atuleu/woodpecker/mx_key_drawing/mx_front.dxf

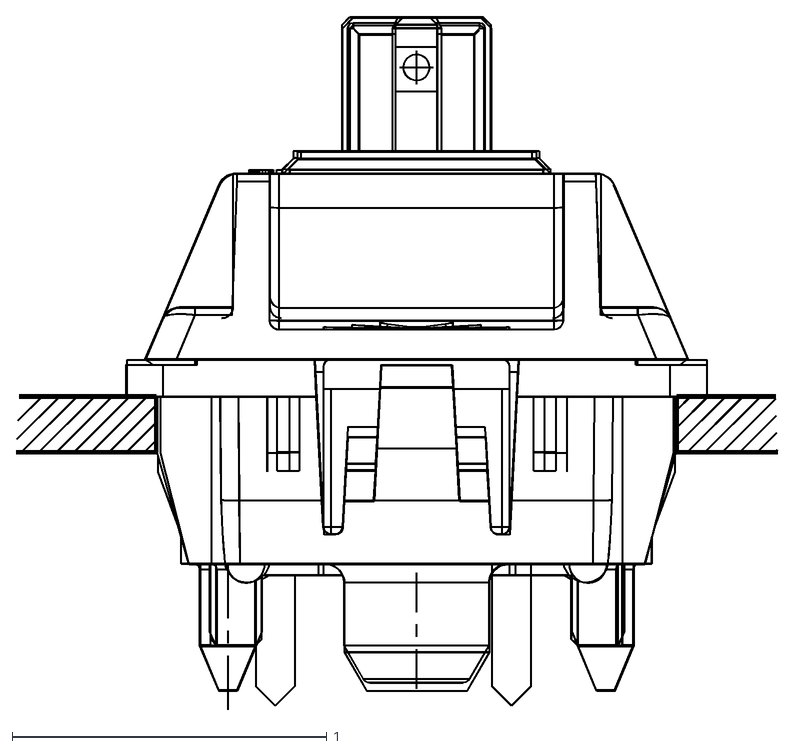
[picture p1: CAD file, 2022-06-14]
mx_key_drawing/mx_front.dxf
2.42 x 2.20
