atuleu/woodpecker/mx_key_drawing/mx_side.dxf

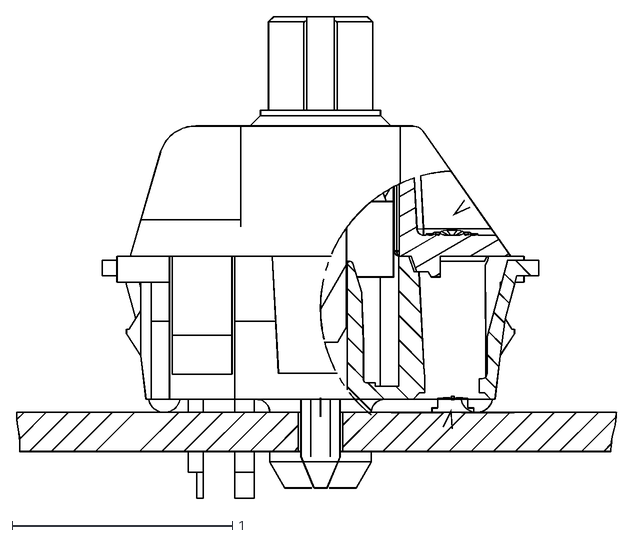
[picture p2: CAD file, 2022-06-14]
mx_key_drawing/mx_side.dxf
2.73 x 2.19
