atuleu/woodpecker/mx_key_drawing/mx_top.dxf

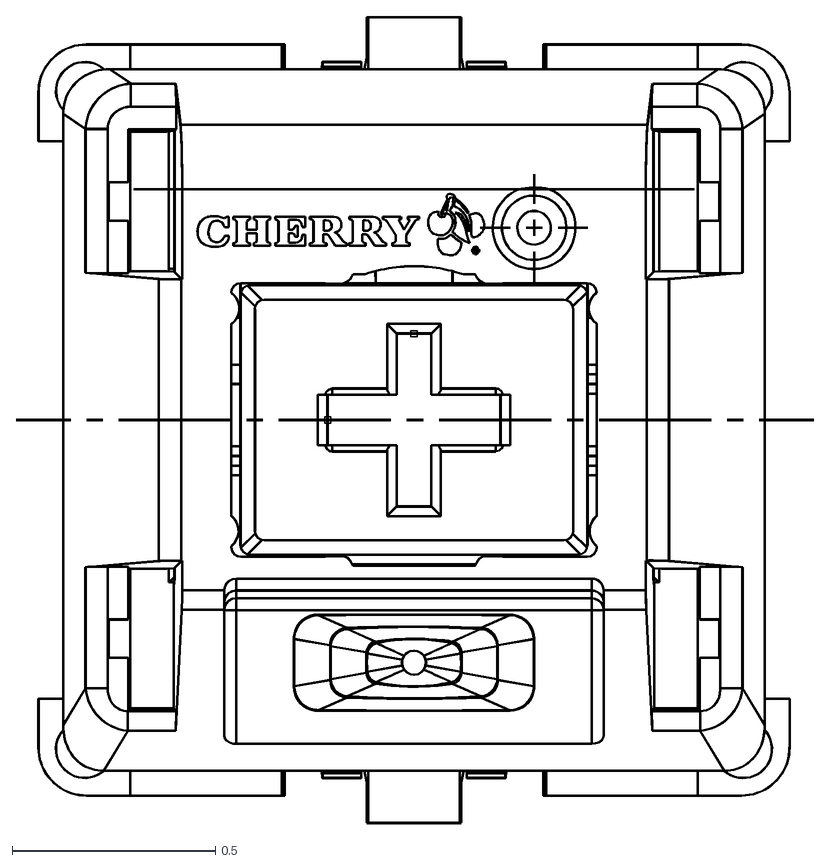
[picture p3: CAD file, 2022-06-14]
mx_key_drawing/mx_top.dxf
1.96 x 1.99
