atuleu/woodpecker/ecad/BottomSection/BottomSection.kicad_pcb

## KiCad design ecad/BottomSection/BottomSection.kicad_pcb (2021-03-28)

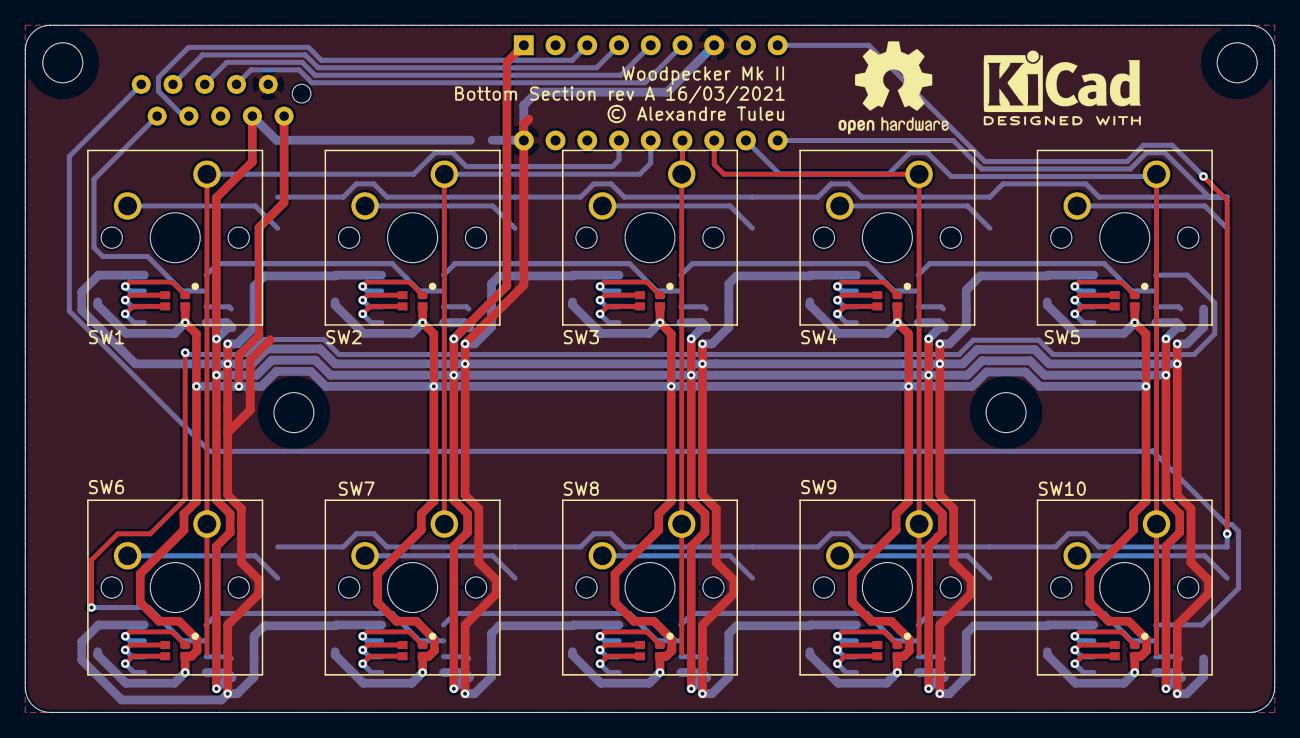
[picture p4: board BottomSection.kicad_pcb from above]

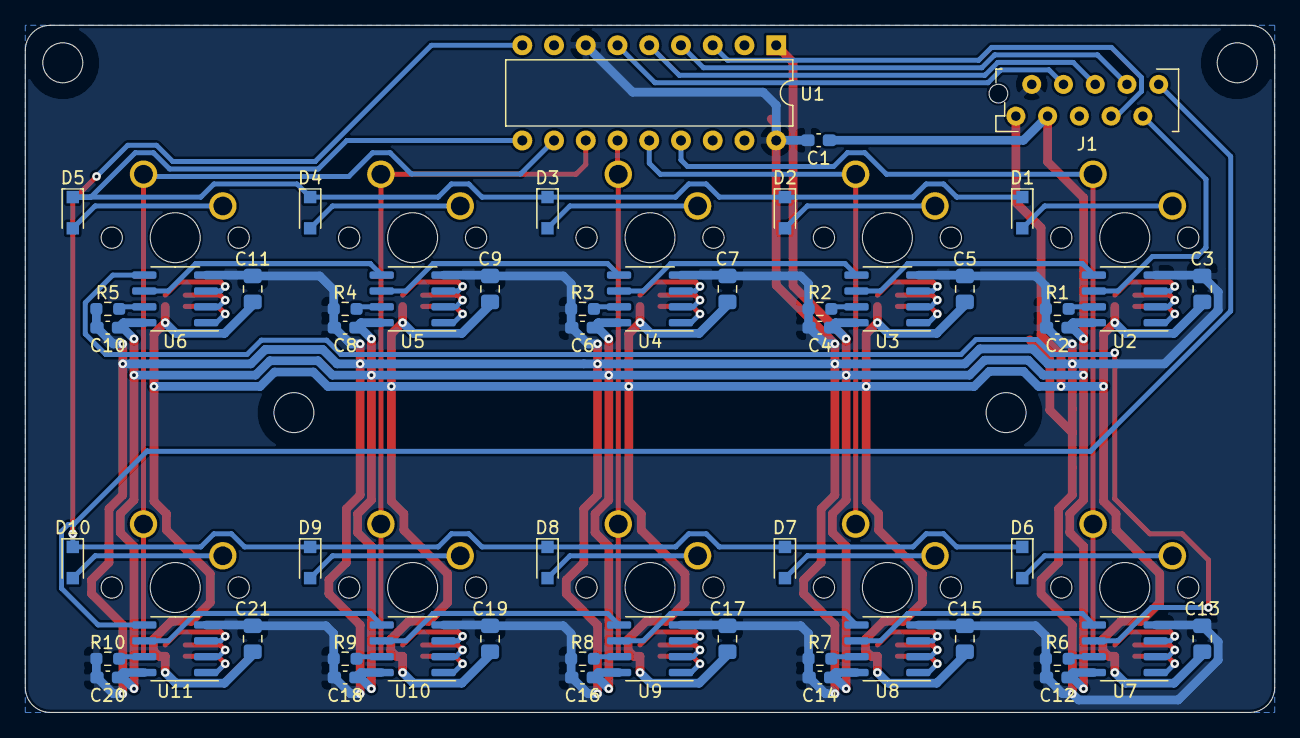
[picture p5: board BottomSection.kicad_pcb from below]

Board: 2 copper layers, 100.0 x 55.0 mm, 67 parts (53 on the bottom side), 75 nets.

Parts:
C1, C2, C4, C6, C8, C10, C12, C14, C16, C18, C20: 100nF; C_0603_1608Metric_Pad1.08x0.95mm_HandSolder
C3, C5, C7, C9, C11, C13, C15, C17, C19, C21: 2.2uF; C_0805_2012Metric_Pad1.18x1.45mm_HandSolder
D1, D2, D3, D4, D5, D6, D7, D8, D9, D10: 1N4148WS; D_SOD-323_HandSoldering
H1, H2, H3, H4: MountingHole; MountingHole_3.2mm_M3_DIN965
J1: Conn_02x05_Odd_Even; ConnectorMicromatch-10
R1, R2, R3, R4, R5, R6, R7, R8, R9, R10: 10.5K; R_0603_1608Metric_Pad0.98x0.95mm_HandSolder
SW1, SW2, SW3, SW4, SW5, SW6, SW7, SW8, SW9, SW10: Cherry_MX_LED; SW_Cherry_MX_1.00u_PCB_SMD_LED
U1: MCP23S09-xP; DIP-18_W7.62mm
U2, U3, U4, U5, U6, U7, U8, U9, U10, U11: TLC5973; SOIC-8_3.9x4.9mm_P1.27mm

Connections:
+3V3: C1.1, C2.1, C4.1, C6.1, C8.1, C10.1, C12.1, C14.1, C16.1, C18.1, C20.1, J1.3, U1.1, U2.8, U3.8, U4.8, U5.8, U6.8, U7.8, U8.8, U9.8, U10.8, U11.8
/C1: SW1.5, SW6.5, U1.15
/C2: SW2.5, SW7.5, U1.14
/C3: SW3.5, SW8.5, U1.13
/C4: SW4.5, SW9.5, U1.12
/C5: SW5.5, SW10.5, U1.11
/DI: J1.9, U2.6
/DO: J1.10, U11.5
/MISO: J1.4, U1.6
/MOSI: J1.6, U1.5
/MX_2/DI: U2.5, U3.6
/MX_3/DI: U3.5, U4.6
/MX_4/DI: U4.5, U5.6
/MX_5/DI: U5.5, U6.6
/MX_6/DI: U6.5, U7.6
/MX_7/DI: U7.5, U8.6
/MX_8/DI: U8.5, U9.6
/MX_9/DI: U9.5, U10.6
/MX_10/DI: U10.5, U11.6
/R1: D1.1, D2.1, D3.1, D4.1, D5.1, U1.10
/R2: D6.1, D7.1, D8.1, D9.1, D10.1, U1.9
/SCK: J1.8, U1.4
/~CS_ROW: J1.7, U1.3
GND: C1.2, C2.2, C3.2, C4.2, C5.2, C6.2, C7.2, C8.2, C9.2, C10.2, C11.2, C12.2, C13.2, C14.2, C15.2, C16.2, C17.2, C18.2, C19.2, C20.2, C21.2, J1.2, R1.2, R2.2, R3.2, R4.2, R5.2, R6.2, R7.2, R8.2, R9.2, R10.2, U1.7, U1.18, U2.4, U3.4, U4.4, U5.4, U6.4, U7.4, U8.4, U9.4, U10.4, U11.4
unnamed: D1.2, SW1.6
unnamed: D2.2, SW2.6
unnamed: D3.2, SW3.6
unnamed: D4.2, SW4.6
unnamed: D5.2, SW5.6
unnamed: D6.2, SW6.6
unnamed: D7.2, SW7.6
unnamed: D8.2, SW8.6
unnamed: D9.2, SW9.6
unnamed: D10.2, SW10.6
unnamed: R1.1, U2.7
unnamed: R2.1, U3.7
unnamed: R3.1, U4.7
unnamed: R4.1, U5.7
unnamed: R5.1, U6.7
unnamed: R6.1, U7.7
unnamed: R7.1, U8.7
unnamed: R8.1, U9.7
unnamed: R9.1, U10.7
unnamed: R10.1, U11.7
unnamed: SW1.1, U2.3
unnamed: SW1.2, U2.2
unnamed: SW1.4, U2.1
unnamed: SW2.1, U3.3
unnamed: SW2.2, U3.2
unnamed: SW2.4, U3.1
unnamed: SW3.1, U4.3
unnamed: SW3.2, U4.2
unnamed: SW3.4, U4.1
unnamed: SW4.1, U5.3
unnamed: SW4.2, U5.2
unnamed: SW4.4, U5.1
unnamed: SW5.1, U6.3
unnamed: SW5.2, U6.2
unnamed: SW5.4, U6.1
unnamed: SW6.1, U7.3
unnamed: SW6.2, U7.2
unnamed: SW6.4, U7.1
unnamed: SW7.1, U8.3
unnamed: SW7.2, U8.2
unnamed: SW7.4, U8.1
unnamed: SW8.1, U9.3
unnamed: SW8.2, U9.2
unnamed: SW8.4, U9.1
unnamed: SW9.1, U10.3
unnamed: SW9.2, U10.2
unnamed: SW9.4, U10.1
unnamed: SW10.1, U11.3
unnamed: SW10.2, U11.2
unnamed: SW10.4, U11.1
VLED: C3.1, C5.1, C7.1, C9.1, C11.1, C13.1, C15.1, C17.1, C19.1, C21.1, J1.1, SW1.3, SW2.3, SW3.3, SW4.3, SW5.3, SW6.3, SW7.3, SW8.3, SW9.3, SW10.3
