atuleu/woodpecker/ecad/TestBoard/TestBoard.kicad_pcb

## KiCad design ecad/TestBoard/TestBoard.kicad_pcb (2021-03-28)

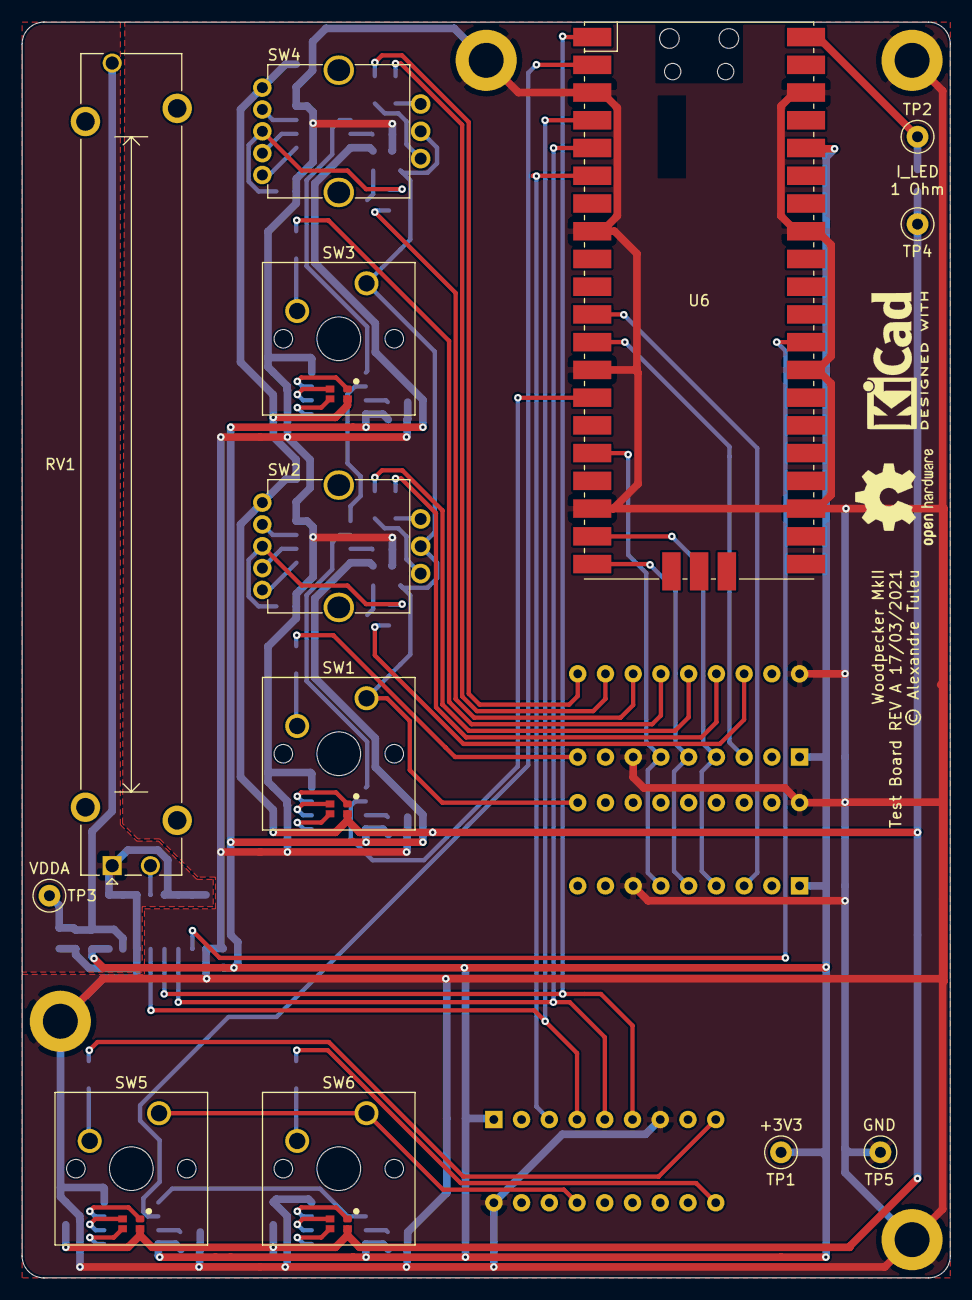
[picture p6: board TestBoard.kicad_pcb from above]

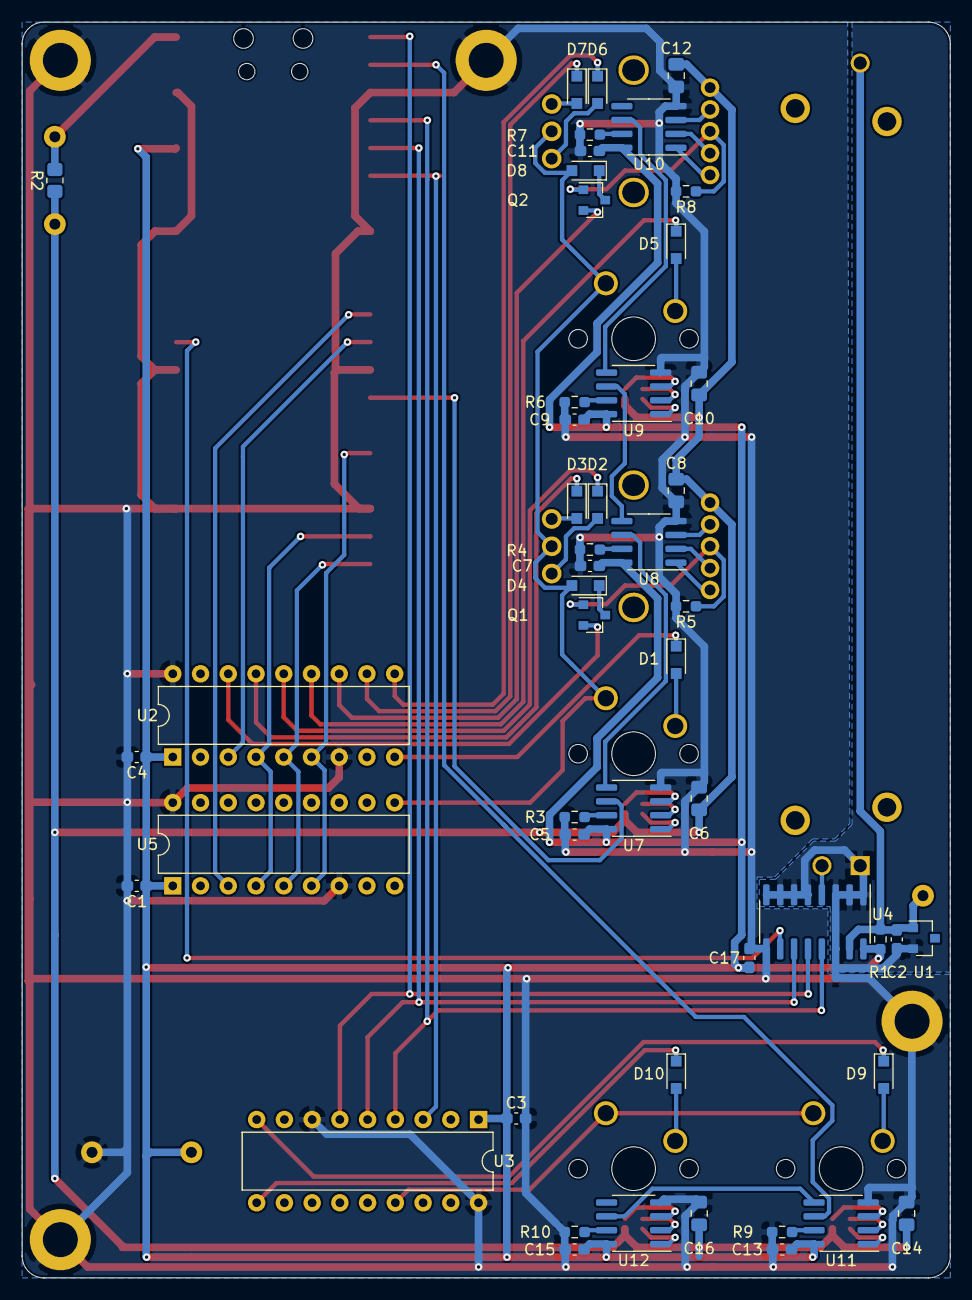
[picture p7: board TestBoard.kicad_pcb from below]

Board: 2 copper layers, 85.0 x 115.0 mm, 64 parts (51 on the bottom side), 71 nets.

Parts:
C1, C2, C3, C4, C5, C7, C9, C11, C13, C15, C17: 100nF; C_0603_1608Metric_Pad1.08x0.95mm_HandSolder
C6, C8, C10, C12, C14, C16: 2.2uF; C_0805_2012Metric_Pad1.18x1.45mm_HandSolder
D1, D2, D3, D4, D5, D6, D7, D8, D9, D10: 1N4148WS; D_SOD-323_HandSoldering
JP1: Jumper; jumper_0_4
Q1, Q2: BSS138; SOT-23
R1: 43R; R_0603_1608Metric_Pad0.98x0.95mm_HandSolder
R2: 1, 1/4W; R_0805_2012Metric_Pad1.20x1.40mm_HandSolder
R3, R4, R6, R7, R9, R10: 10.5K; R_0603_1608Metric_Pad0.98x0.95mm_HandSolder
R5, R8: 10K; R_0603_1608Metric_Pad0.98x0.95mm_HandSolder
RV1: R_POT; Potentiometer_Bourns_PTA6043_Single_Slide
SW1, SW3, SW5, SW6: Cherry_MX_LED; SW_Cherry_MX_1.00u_PCB_SMD_LED
SW2, SW4: PEL12T; PEL12T-4xxxS-S1024
TP1: 3V3; TestPoint_Loop_D2.50mm_Drill1.0mm_LowProfile
TP2: VBUS; TestPoint_Loop_D2.50mm_Drill1.0mm_LowProfile
TP3: VDDA; TestPoint_Loop_D2.50mm_Drill1.0mm_LowProfile
TP4: VLED; TestPoint_Loop_D2.50mm_Drill1.0mm_LowProfile
TP5: GND; TestPoint_Loop_D2.50mm_Drill1.0mm_LowProfile
U1: LM4040DBZ-3; SOT-23
U2, U3, U5: MCP23S09-xP; DIP-18_W7.62mm
U4: MCP3008; SOIC-16_3.9x9.9mm_P1.27mm
U6: RPI_Pico; RPi_Pico_SMD
U7, U8, U9, U10, U11, U12: TLC5973; SOIC-8_3.9x4.9mm_P1.27mm

Connections:
+3V3: C1.1, C3.1, C4.1, C5.1, C7.1, C9.1, C11.1, C13.1, C15.1, C17.1, R1.1, TP1.1, U2.1, U3.1, U4.16, U5.1, U6.36, U7.8, U8.8, U9.8, U10.8, U11.8, U12.8
/BOT_C_DI: U6.2, U11.6
/BOT_MISO: U3.6, U4.12, U6.1
/BOT_MOSI: U3.5, U4.11, U6.5
/BOT_SCK: U3.4, U4.13, U6.4
/CBOT: SW5.5, SW6.5, U3.15
/CTOP: D4.2, D8.2, SW1.5, SW2.C, SW3.5, SW4.C, U5.10
/PT1: RV1.2, U4.4
/QA1: D6.1, U2.10
/QA2: D2.1, U2.14
/QB1: D7.1, U2.11
/QB2: D3.1, U2.15
/R1: Q2.2, U2.12
/R2: D5.1, U2.13
/R3: Q1.2, U2.16
/R4: D1.1, U2.9
/R5: D9.1, U3.9
/R6: D10.1, U3.10
/Sheet60629BEB/DI: U9.5, U10.6
/Sheet60634508/DI: U8.5, U9.6
/TOP_C_DI: U6.14, U7.6
/TOP_MISO: U2.6, U5.6, U6.16
/TOP_MOSI: U2.5, U5.5, U6.20
/TOP_SCK: U2.4, U5.4, U6.19
/sheet607AC642/DI: U11.5, U12.6
/sheet60638B8E/DI: U7.5, U8.6
/~CS_ADC_C: U4.10, U6.29
/~CS_COL_C: U5.3, U6.11
/~CS_MX_C: U3.3, U6.6
/~CS_ROW_C: U2.3, U6.12
GND: C1.2, C3.2, C4.2, C5.2, C6.2, C7.2, C8.2, C9.2, C10.2, C11.2, C12.2, C13.2, C14.2, C15.2, C16.2, C17.2, JP1.2, R3.2, R4.2, R5.2, R6.2, R7.2, R8.2, R9.2, R10.2, TP5.1, U2.7, U2.18, U3.7, U3.18, U4.9, U5.7, U5.18, U6.3, U6.8, U6.13, U6.18, U6.23, U6.28, U6.33, U6.38, U7.4, U8.4, U9.4, U10.4, U11.4, U12.4
GND1: C2.2, JP1.1, RV1.1, U1.2, U4.1, U4.2, U4.3, U4.5, U4.6, U4.7, U4.8, U4.14
unnamed: D1.2, SW1.6
unnamed: D2.2, SW2.A
unnamed: D3.2, SW2.B
unnamed: D4.1, Q1.3
unnamed: D5.2, SW3.6
unnamed: D6.2, SW4.A
unnamed: D7.2, SW4.B
unnamed: D8.1, Q2.3
unnamed: D9.2, SW5.6
unnamed: D10.2, SW6.6
unnamed: Q1.1, R5.1, SW2.3
unnamed: Q2.1, R8.1, SW4.3
unnamed: R3.1, U7.7
unnamed: R4.1, U8.7
unnamed: R6.1, U9.7
unnamed: R7.1, U10.7
unnamed: R9.1, U11.7
unnamed: R10.1, U12.7
unnamed: SW1.1, U7.3
unnamed: SW1.2, U7.2
unnamed: SW1.4, U7.1
unnamed: SW2.1, U8.1
unnamed: SW2.2, U8.2
unnamed: SW2.4, U8.3
unnamed: SW3.1, U9.3
unnamed: SW3.2, U9.2
unnamed: SW3.4, U9.1
unnamed: SW4.1, U10.1
unnamed: SW4.2, U10.2
unnamed: SW4.4, U10.3
unnamed: SW5.1, U11.3
unnamed: SW5.2, U11.2
unnamed: SW5.4, U11.1
unnamed: SW6.1, U12.3
unnamed: SW6.2, U12.2
unnamed: SW6.4, U12.1
VBUS: R2.2, TP2.1, U6.40
VDDA: C2.1, R1.2, RV1.3, TP3.1, U1.1, U4.15
VLED: C6.1, C8.1, C10.1, C12.1, C14.1, C16.1, R2.1, SW1.3, SW2.5, SW3.3, SW4.5, SW5.3, SW6.3, TP4.1
