atuleu/woodpecker/ecad/MiddleSection/MiddleSection.kicad_pcb

## KiCad design ecad/MiddleSection/MiddleSection.kicad_pcb (2021-03-28)

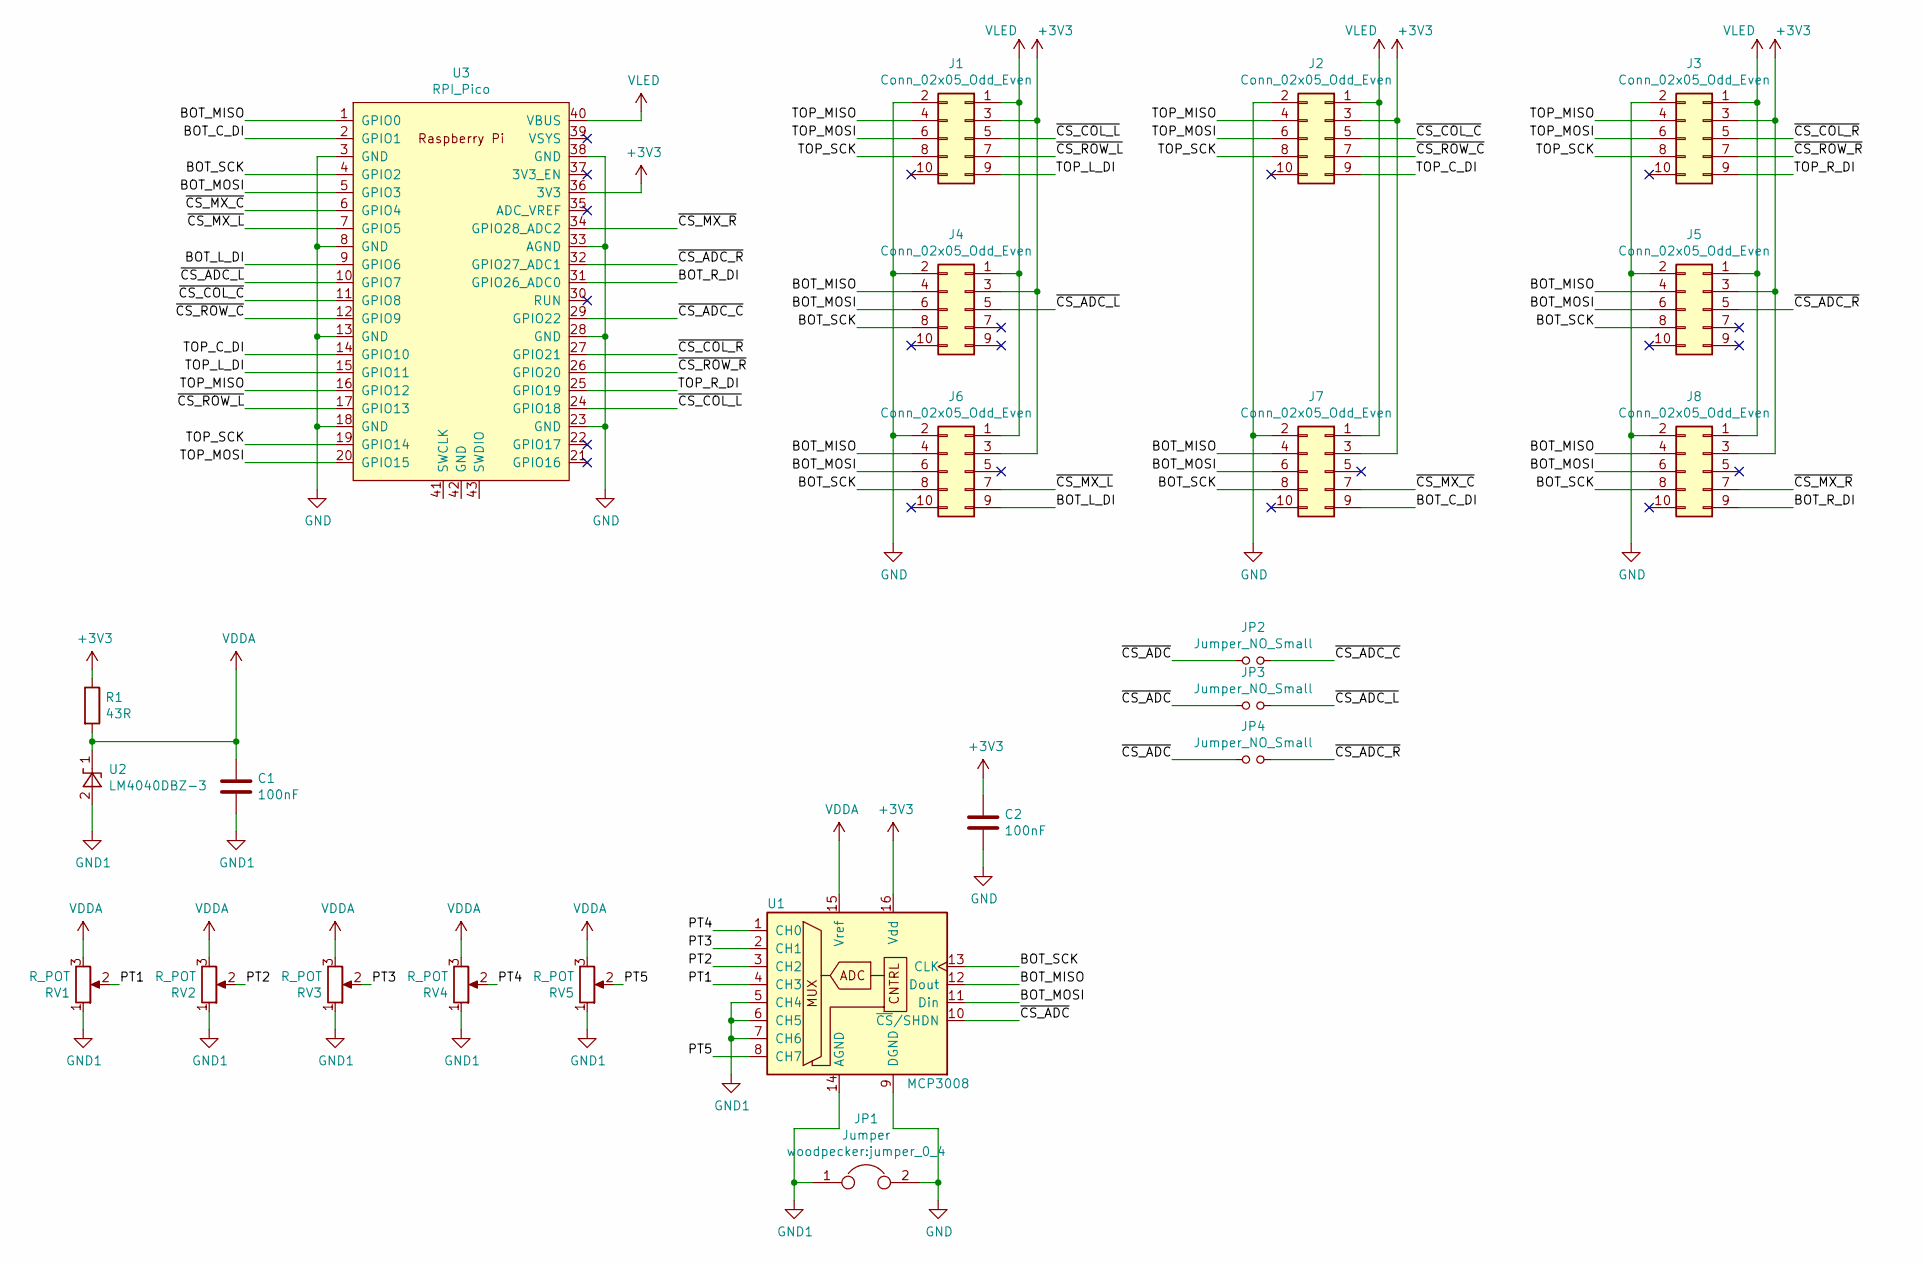
[picture p8: schematic MiddleSection.sch]

Parts:
C1, C2: 100nF; C_0603_1608Metric_Pad1.08x0.95mm_HandSolder
J1, J2, J3, J4, J5, J6, J7, J8: Conn_02x05_Odd_Even; ConnectorMicromatch-10
JP1: Jumper; jumper_0_4
JP2, JP3, JP4: Jumper_NO_Small; SolderJumper-2_P1.3mm_Open_RoundedPad1.0x1.5mm
R1: 43R; R_0603_1608Metric_Pad0.98x0.95mm_HandSolder
RV1, RV2, RV3, RV4, RV5: R_POT; Potentiometer_Bourns_PTA6043_Single_Slide
U1: MCP3008; SOIC-16_3.9x9.9mm_P1.27mm
U2: LM4040DBZ-3; SOT-23
U3: RPI_Pico; RPi_Pico_SMD_TH

Connections:
+3V3: C2.1, J1.3, J2.3, J3.3, J4.3, J5.3, J6.3, J7.3, J8.3, R1.1, U1.16 (Vdd), U3.36 (3V3)
/BOT_C_DI: J7.9, U3.2 (GPIO1)
/BOT_L_DI: J6.9, U3.9 (GPIO6)
/BOT_MISO: J4.4, J5.4, J6.4, J7.4, J8.4, U1.12 (Dout), U3.1 (GPIO0)
/BOT_MOSI: J4.6, J5.6, J6.6, J7.6, J8.6, U1.11 (Din), U3.5 (GPIO3)
/BOT_R_DI: J8.9, U3.31 (GPIO26_ADC0)
/BOT_SCK: J4.8, J5.8, J6.8, J7.8, J8.8, U1.13 (CLK), U3.4 (GPIO2)
/PT1: RV1.2, U1.4 (CH3)
/PT2: RV2.2, U1.3 (CH2)
/PT3: RV3.2, U1.2 (CH1)
/PT4: RV4.2, U1.1 (CH0)
/PT5: RV5.2, U1.8 (CH7)
/TOP_C_DI: J2.9, U3.14 (GPIO10)
/TOP_L_DI: J1.9, U3.15 (GPIO11)
/TOP_MISO: J1.4, J2.4, J3.4, U3.16 (GPIO12)
/TOP_MOSI: J1.6, J2.6, J3.6, U3.20 (GPIO15)
/TOP_R_DI: J3.9, U3.25 (GPIO19)
/TOP_SCK: J1.8, J2.8, J3.8, U3.19 (GPIO14)
/~CS_ADC: JP2.1, JP3.1, JP4.1, U1.10 (~CS~/SHDN)
/~CS_ADC_C: JP2.2, U3.29 (GPIO22)
/~CS_ADC_L: J4.5, JP3.2, U3.10 (GPIO7)
/~CS_ADC_R: J5.5, JP4.2, U3.32 (GPIO27_ADC1)
/~CS_COL_C: J2.5, U3.11 (GPIO8)
/~CS_COL_L: J1.5, U3.24 (GPIO18)
/~CS_COL_R: J3.5, U3.27 (GPIO21)
/~CS_MX_C: J7.7, U3.6 (GPIO4)
/~CS_MX_L: J6.7, U3.7 (GPIO5)
/~CS_MX_R: J8.7, U3.34 (GPIO28_ADC2)
/~CS_ROW_C: J2.7, U3.12 (GPIO9)
/~CS_ROW_L: J1.7, U3.17 (GPIO13)
/~CS_ROW_R: J3.7, U3.26 (GPIO20)
GND: C2.2, J1.2, J2.2, J3.2, J4.2, J5.2, J6.2, J7.2, J8.2, JP1.2, U1.9 (DGND), U3.3 (GND), U3.8 (GND), U3.13 (GND), U3.18 (GND), U3.23 (GND), U3.28 (GND), U3.33 (AGND), U3.38 (GND)
GND1: C1.2, JP1.1, RV1.1, RV2.1, RV3.1, RV4.1, RV5.1, U1.5 (CH4), U1.6 (CH5), U1.7 (CH6), U1.14 (AGND), U2.2 (A)
VDDA: C1.1, R1.2, RV1.3, RV2.3, RV3.3, RV4.3, RV5.3, U1.15 (Vref), U2.1 (K)
VLED: J1.1, J2.1, J3.1, J4.1, J5.1, J6.1, J7.1, J8.1, U3.40 (VBUS)

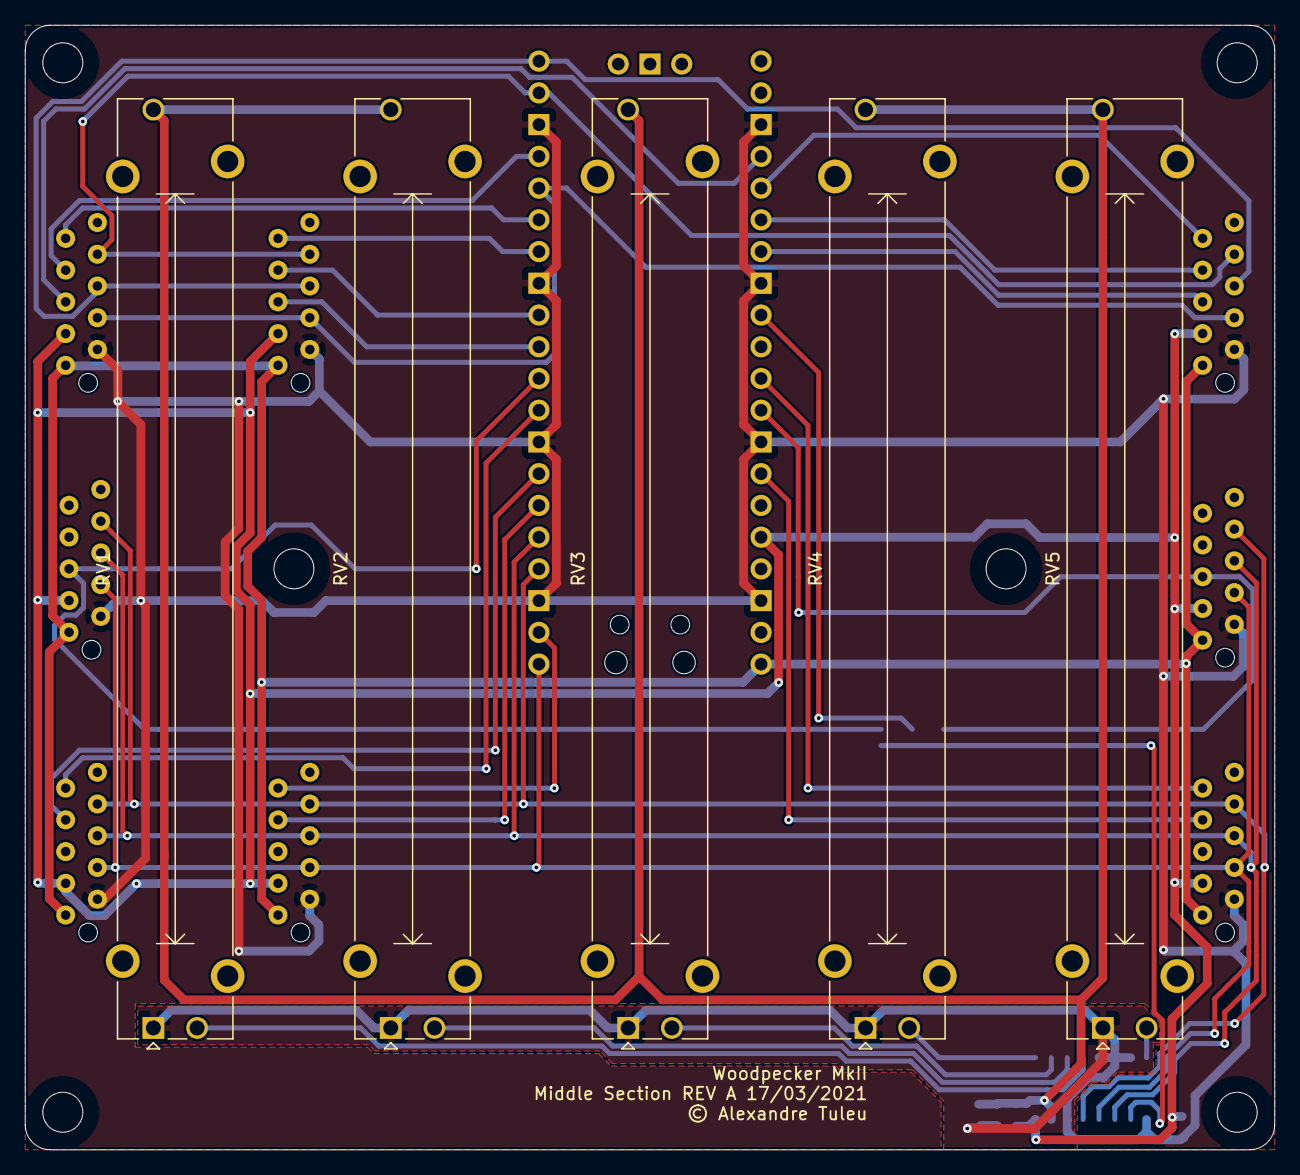
[picture p9: board MiddleSection.kicad_pcb from above]

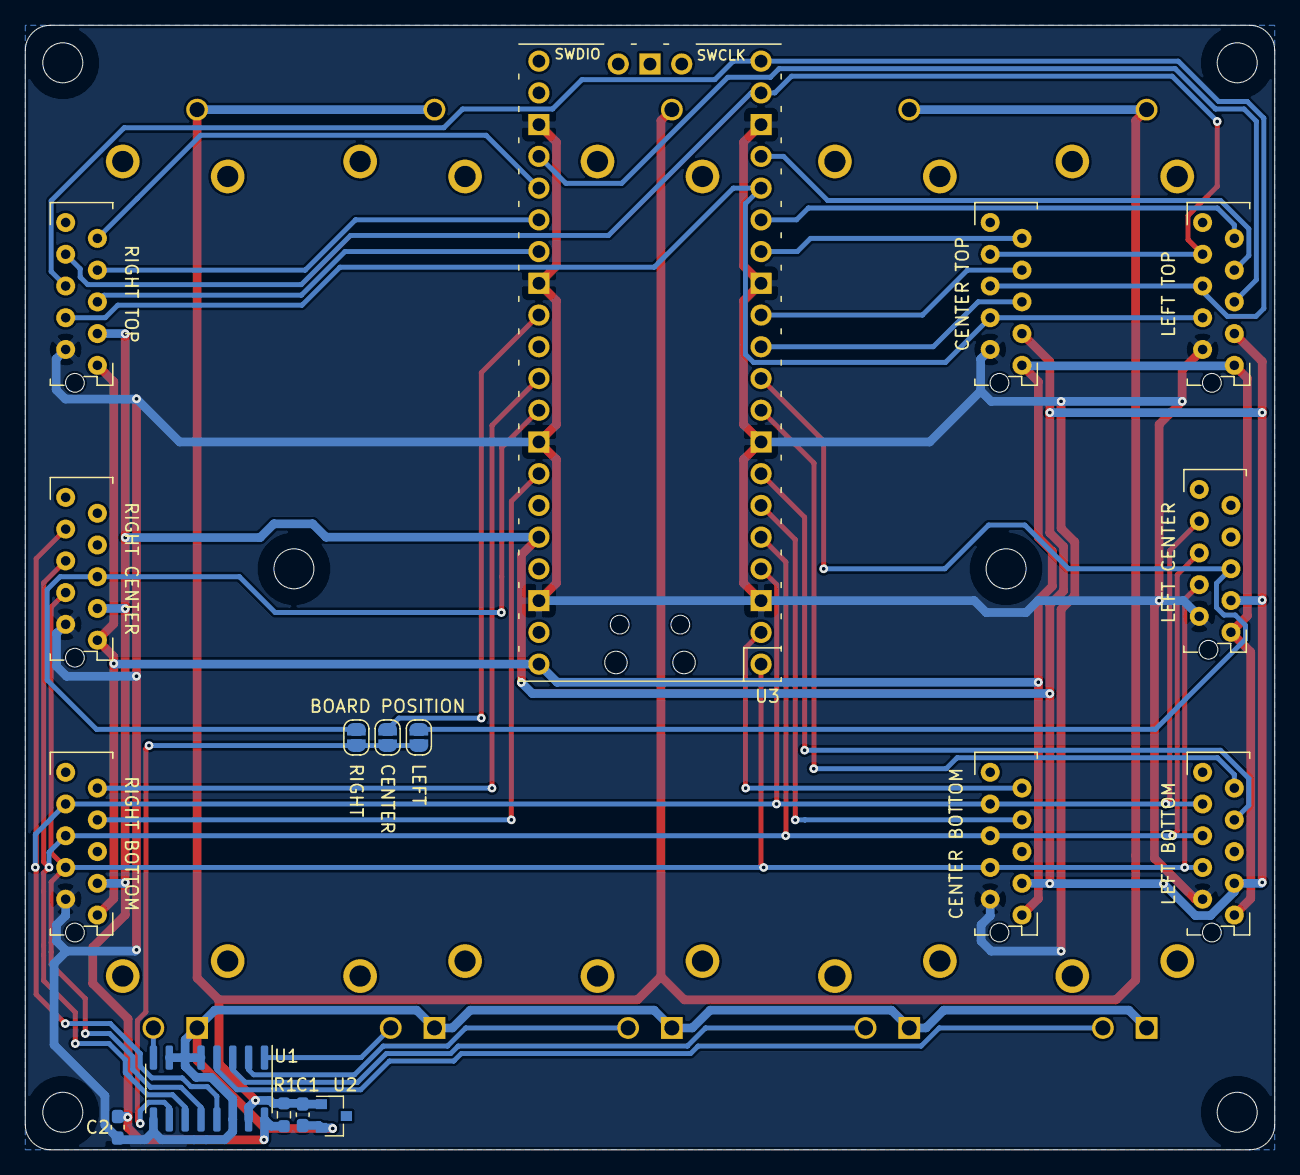
[picture p10: board MiddleSection.kicad_pcb from below]

Board: 2 copper layers, 100.0 x 90.0 mm, 23 parts (18 on the bottom side), 35 nets.
