atuleu/woodpecker/ecad/TopSection/TopSection.kicad_pcb

## KiCad design ecad/TopSection/TopSection.kicad_pcb (2021-03-28)

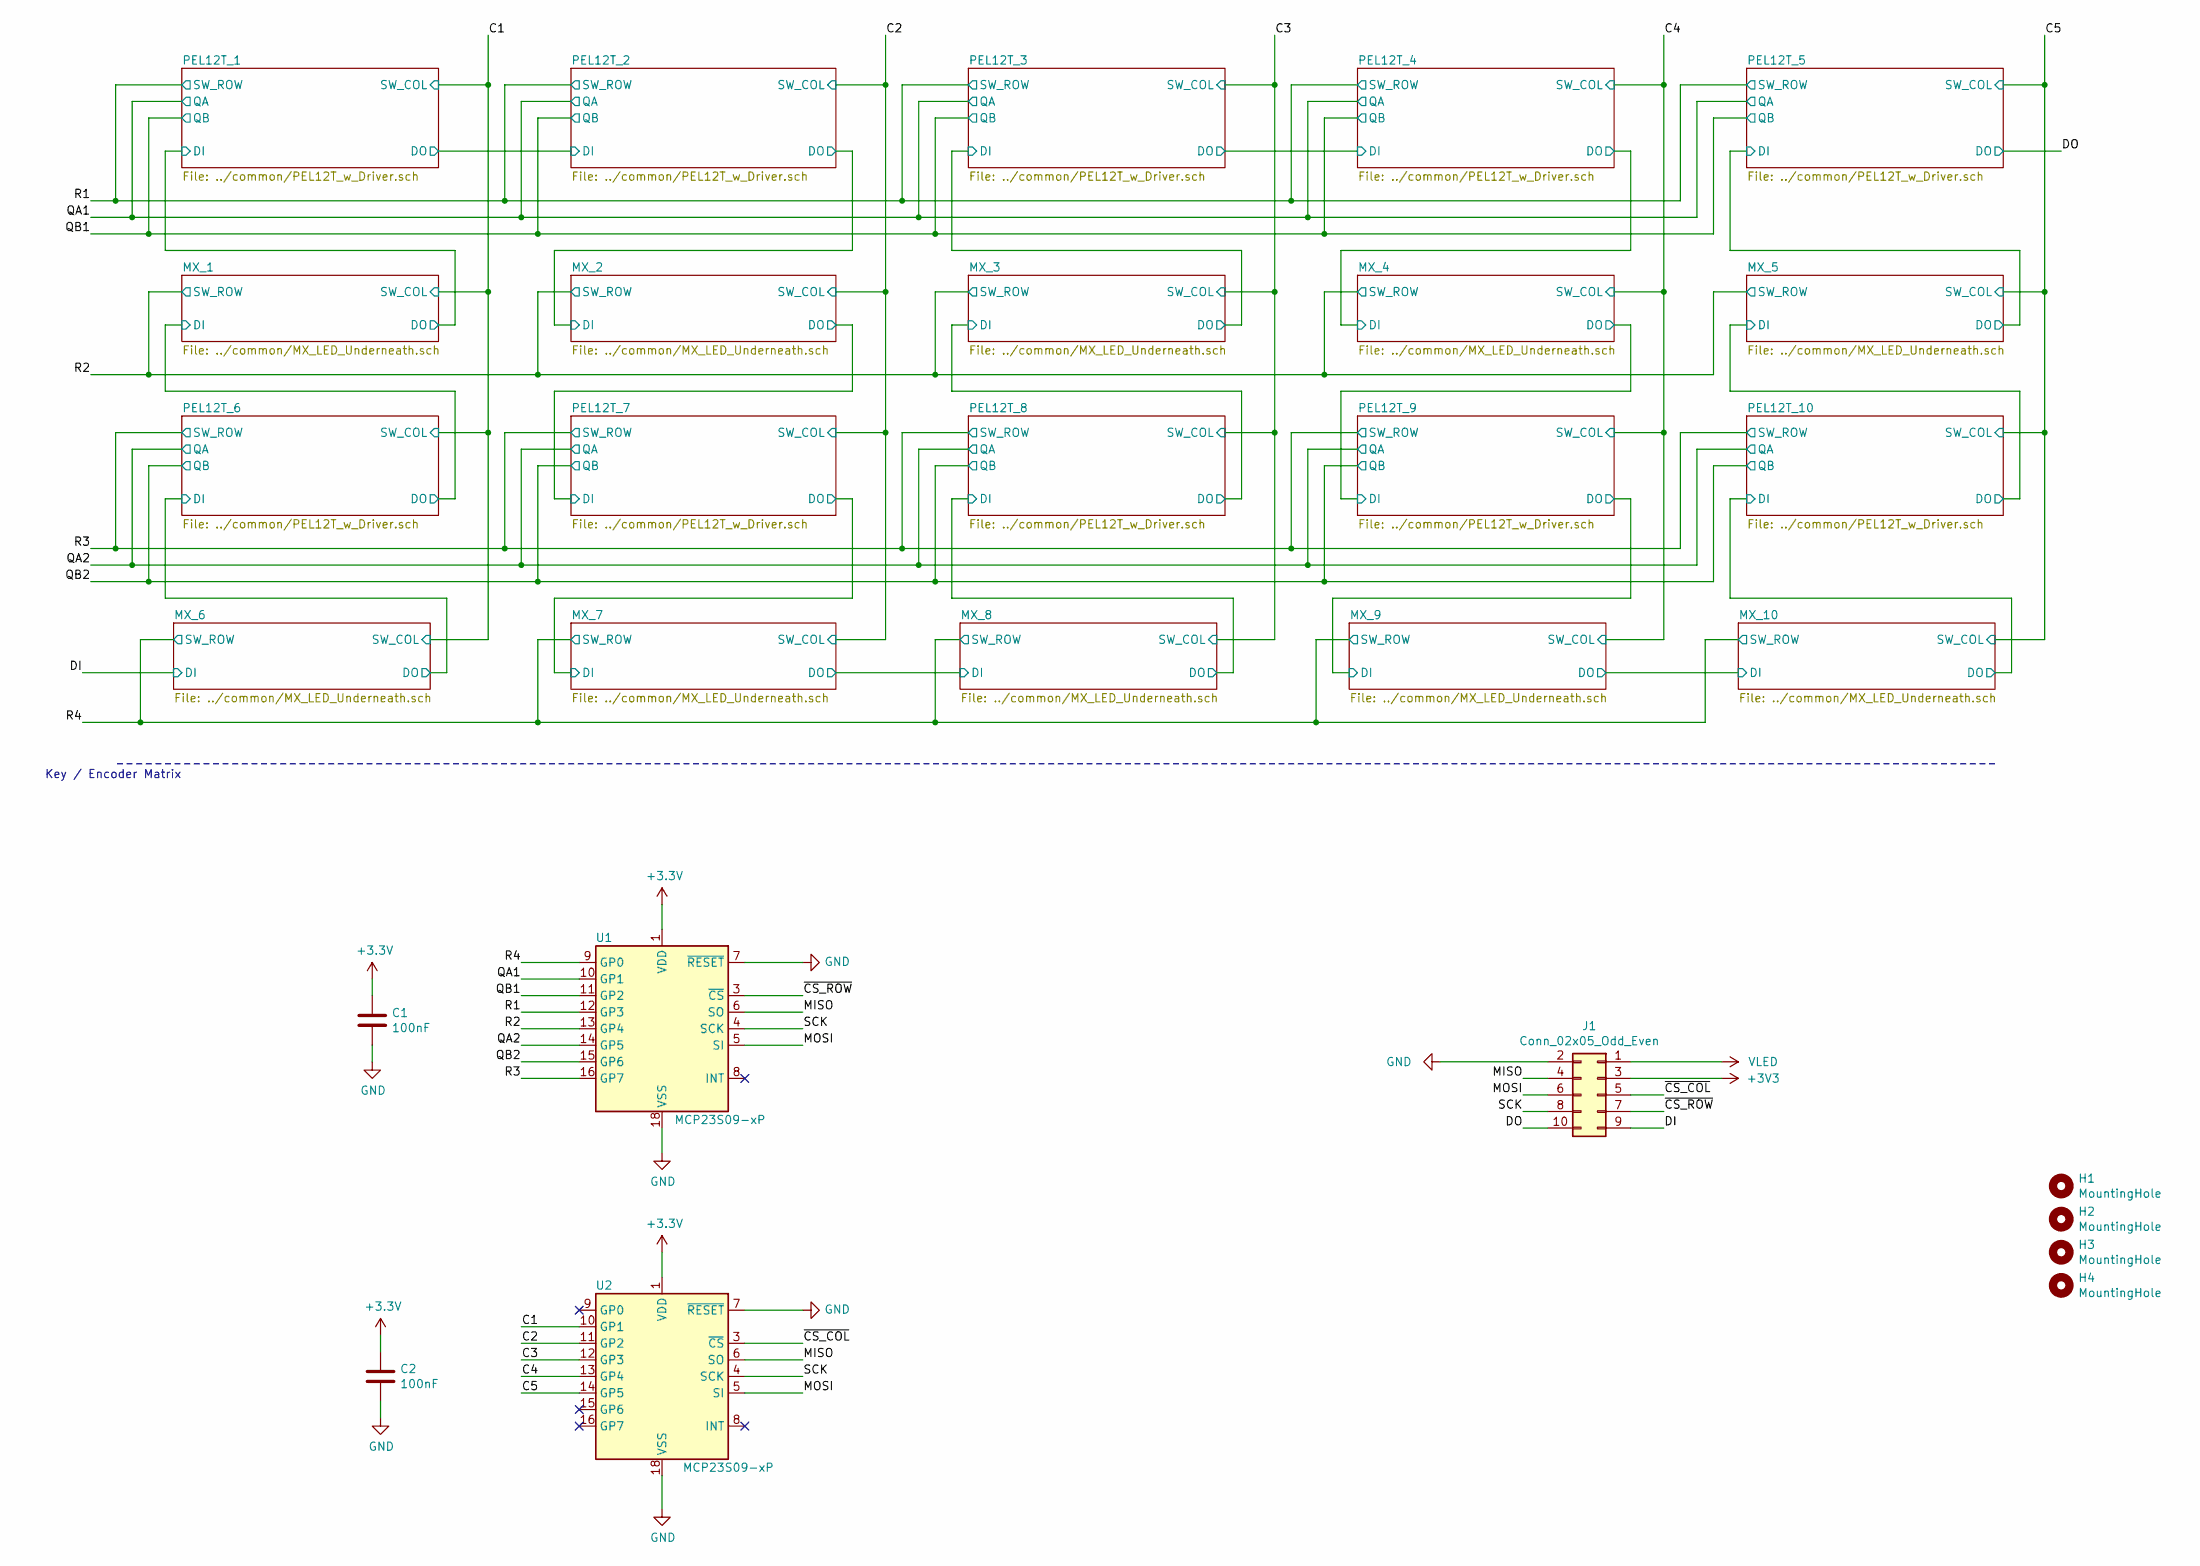
[picture p11: schematic TopSection.sch]

Parts:
C1, C2: 100nF; C_0603_1608Metric_Pad1.08x0.95mm_HandSolder
H1, H2, H3, H4: MountingHole; MountingHole_3.2mm_M3_DIN965
J1: Conn_02x05_Odd_Even; ConnectorMicromatch-10
U1, U2: MCP23S09-xP; DIP-18_W7.62mm

Connections:
/C1: U2.10 (GP1); also elsewhere on the board
/C2: U2.11 (GP2); also elsewhere on the board
/C3: U2.12 (GP3); also elsewhere on the board
/C4: U2.13 (GP4); also elsewhere on the board
/C5: U2.14 (GP5); also elsewhere on the board
/DI: J1.9; also elsewhere on the board
/DO: J1.10; also elsewhere on the board
/MISO: J1.4, U1.6 (SO), U2.6 (SO)
/MOSI: J1.6, U1.5 (SI), U2.5 (SI)
/QA1: U1.10 (GP1); also elsewhere on the board
/QA2: U1.14 (GP5); also elsewhere on the board
/QB1: U1.11 (GP2); also elsewhere on the board
/QB2: U1.15 (GP6); also elsewhere on the board
/R1: U1.12 (GP3); also elsewhere on the board
/R2: U1.13 (GP4); also elsewhere on the board
/R3: U1.16 (GP7); also elsewhere on the board
/R4: U1.9 (GP0); also elsewhere on the board
/SCK: J1.8, U1.4 (SCK), U2.4 (SCK)
/~CS_COL: J1.5, U2.3 (~CS)
/~CS_ROW: J1.7, U1.3 (~CS)
GND: C1.2, C2.2, J1.2, U1.7 (~RESET), U1.18 (VSS), U2.7 (~RESET), U2.18 (VSS); also elsewhere on the board
VLED: J1.1; also elsewhere on the board

Notes on the sheet:
Key / Encoder Matrix
