atuleu/woodpecker/ecad/TopSection/TopSection.kicad_pcb

## KiCad design ecad/TopSection/TopSection.kicad_pcb (continued)

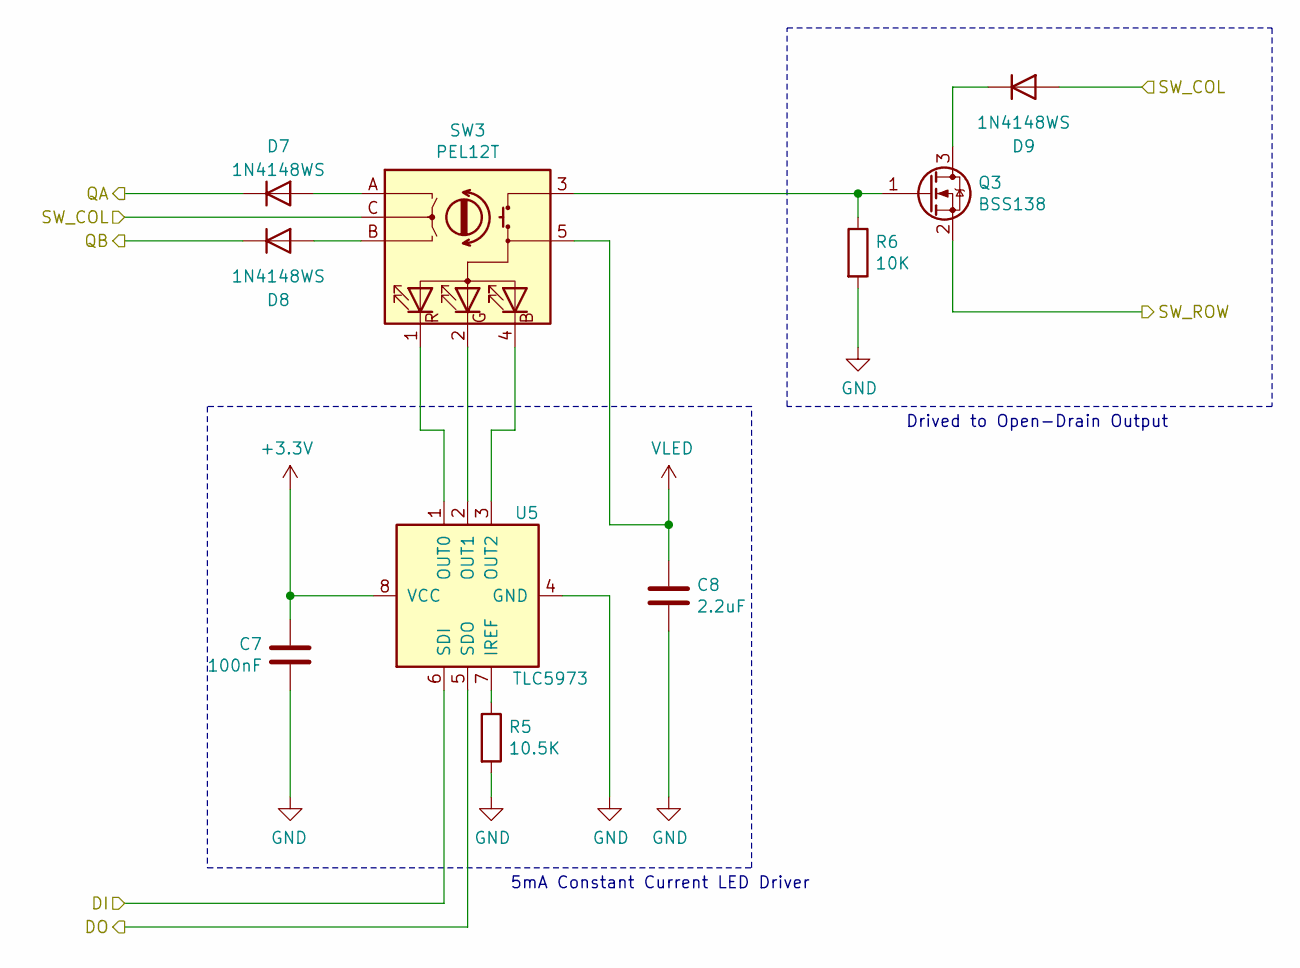
[picture p12: schematic PEL12T_w_Driver.sch]

Parts:
C3: 100nF; C_0603_1608Metric_Pad1.08x0.95mm_HandSolder
C4: 2.2uF; C_0805_2012Metric_Pad1.18x1.45mm_HandSolder
D1, D2, D3: 1N4148WS; D_SOD-323_HandSoldering
Q1: BSS138; SOT-23
R1: 10.5K; R_0603_1608Metric_Pad0.98x0.95mm_HandSolder
R2: 10K; R_0603_1608Metric_Pad0.98x0.95mm_HandSolder
SW1: PEL12T; PEL12T-4xxxS-S1024
U3: TLC5973; SOIC-8_3.9x4.9mm_P1.27mm

Connections:
/C1: D3.2 (A), SW1.C; also elsewhere on the board
/PEL12T_1/DI: U3.6 (SDI); also elsewhere on the board
/PEL12T_2/DI: U3.5 (SDO); also elsewhere on the board
/QA1: D1.1 (K); also elsewhere on the board
/QB1: D2.1 (K); also elsewhere on the board
/R1: Q1.2 (S); also elsewhere on the board
GND: C3.2, C4.2, R1.2, R2.2, U3.4 (GND); also elsewhere on the board
unnamed: D1.2 (A), SW1.A
unnamed: D2.2 (A), SW1.B
unnamed: D3.1 (K), Q1.3 (D)
unnamed: Q1.1 (G), R2.1, SW1.3
unnamed: R1.1, U3.7 (IREF)
unnamed: SW1.1 (RK), U3.1 (OUT0)
unnamed: SW1.2 (GK), U3.2 (OUT1)
unnamed: SW1.4 (BK), U3.3 (OUT2)
VLED: C4.1, SW1.5 (A); also elsewhere on the board

Parts of its further copies:
C5, C7, C9, C11, C23, C25, C27, C29, C31: 100nF; C_0603_1608Metric_Pad1.08x0.95mm_HandSolder
C6, C8, C10, C12, C24, C26, C28, C30, C32: 2.2uF; C_0805_2012Metric_Pad1.18x1.45mm_HandSolder
D4, D5, D6, D7, D8, D9, D10, D11, D12, D13, D14, D15, D21, D22, D23, D24, D25, D26, D27, D28, D29, D30, D31, D32, D33, D34, D35: 1N4148WS; D_SOD-323_HandSoldering
Q2, Q3, Q4, Q5, Q6, Q7, Q8, Q9, Q10: BSS138; SOT-23
R3, R7, R9, R16, R18, R20, R22, R24: 10.5K; R_0603_1608Metric_Pad0.98x0.95mm_HandSolder
R4, R6, R8, R10, R17, R19, R21, R23, R25: 10K; R_0603_1608Metric_Pad0.98x0.95mm_HandSolder
SW2, SW3, SW4, SW5, SW11, SW12, SW13, SW14, SW15: PEL12T; PEL12T-4xxxS-S1024
U4, U5, U6, U7, U10, U13, U14, U15, U16, U17: TLC5973; SOIC-8_3.9x4.9mm_P1.27mm

Connections of its further copies:
/C1: D23.2 (A), SW11.C; also elsewhere on the board
/C2: D6.2 (A), D26.2 (A), SW2.C, SW12.C; also elsewhere on the board
/C3: D9.2 (A), D29.2 (A), SW3.C, SW13.C; also elsewhere on the board
/C4: D12.2 (A), D32.2 (A), SW4.C, SW14.C; also elsewhere on the board
/C5: D15.2 (A), D35.2 (A), SW5.C, SW15.C; also elsewhere on the board
/DO: U7.5 (SDO); also elsewhere on the board
/MX_1/DI: U13.5 (SDO); also elsewhere on the board
/MX_2/DI: U4.5 (SDO); also elsewhere on the board
/MX_3/DI: U10.6 (SDI), U15.5 (SDO)
/MX_4/DI: U6.5 (SDO); also elsewhere on the board
/MX_5/DI: U17.5 (SDO); also elsewhere on the board
/MX_7/DI: U14.5 (SDO); also elsewhere on the board
/MX_9/DI: U16.5 (SDO); also elsewhere on the board
/PEL12T_2/DI: U4.6 (SDI); also elsewhere on the board
/PEL12T_3/DI: U5.6 (SDI), U10.5 (SDO)
/PEL12T_4/DI: U5.5 (SDO), U6.6 (SDI)
/PEL12T_5/DI: U7.6 (SDI); also elsewhere on the board
/PEL12T_6/DI: U13.6 (SDI); also elsewhere on the board
/PEL12T_7/DI: U14.6 (SDI); also elsewhere on the board
/PEL12T_8/DI: U15.6 (SDI); also elsewhere on the board
/PEL12T_9/DI: U16.6 (SDI); also elsewhere on the board
/PEL12T_10/DI: U17.6 (SDI); also elsewhere on the board
/QA1: D4.1 (K), D7.1 (K), D10.1 (K), D13.1 (K); also elsewhere on the board
/QA2: D21.1 (K), D24.1 (K), D27.1 (K), D30.1 (K), D33.1 (K); also elsewhere on the board
/QB1: D5.1 (K), D8.1 (K), D11.1 (K), D14.1 (K); also elsewhere on the board
/QB2: D22.1 (K), D25.1 (K), D28.1 (K), D31.1 (K), D34.1 (K); also elsewhere on the board
/R1: Q2.2 (S), Q3.2 (S), Q4.2 (S), Q5.2 (S); also elsewhere on the board
/R3: Q6.2 (S), Q7.2 (S), Q8.2 (S), Q9.2 (S), Q10.2 (S); also elsewhere on the board
GND: C5.2, C6.2, C7.2, C8.2, C9.2, C10.2, C11.2, C12.2, C23.2, C24.2, C25.2, C26.2, C27.2, C28.2, C29.2, C30.2, C31.2, C32.2, R3.2, R4.2, R6.2, R7.2, R8.2, R9.2, R10.2, R16.2, R17.2, R18.2, R19.2, R20.2, R21.2, R22.2, R23.2, R24.2, R25.2, U4.4 (GND), U5.4 (GND), U6.4 (GND), U7.4 (GND), U10.4 (GND), U13.4 (GND), U14.4 (GND), U15.4 (GND), U16.4 (GND), U17.4 (GND); also elsewhere on the board
unnamed: D4.2 (A), SW2.A
unnamed: D5.2 (A), SW2.B
unnamed: D6.1 (K), Q2.3 (D)
unnamed: D7.2 (A), SW3.A
unnamed: D8.2 (A), SW3.B
unnamed: D9.1 (K), Q3.3 (D)
unnamed: D10.2 (A), SW4.A
unnamed: D11.2 (A), SW4.B
unnamed: D12.1 (K), Q4.3 (D)
unnamed: D13.2 (A), SW5.A
unnamed: D14.2 (A), SW5.B
unnamed: D15.1 (K), Q5.3 (D)
unnamed: D21.2 (A), SW11.A
unnamed: D22.2 (A), SW11.B
unnamed: D23.1 (K), Q6.3 (D)
unnamed: D24.2 (A), SW12.A
unnamed: D25.2 (A), SW12.B
unnamed: D26.1 (K), Q7.3 (D)
unnamed: D27.2 (A), SW13.A
unnamed: D28.2 (A), SW13.B
unnamed: D29.1 (K), Q8.3 (D)
unnamed: D30.2 (A), SW14.A
unnamed: D31.2 (A), SW14.B
unnamed: D32.1 (K), Q9.3 (D)
unnamed: D33.2 (A), SW15.A
unnamed: D34.2 (A), SW15.B
unnamed: D35.1 (K), Q10.3 (D)
unnamed: Q2.1 (G), R4.1, SW2.3
unnamed: Q3.1 (G), R6.1, SW3.3
unnamed: Q4.1 (G), R8.1, SW4.3
unnamed: Q5.1 (G), R10.1, SW5.3
unnamed: Q6.1 (G), R17.1, SW11.3
unnamed: Q7.1 (G), R19.1, SW12.3
unnamed: Q8.1 (G), R21.1, SW13.3
unnamed: Q9.1 (G), R23.1, SW14.3
unnamed: Q10.1 (G), R25.1, SW15.3
unnamed: R3.1, U4.7 (IREF)
unnamed 92: U5.7 (IREF); also elsewhere on the board
unnamed: R7.1, U6.7 (IREF)
unnamed: R9.1, U7.7 (IREF)
unnamed 97: U10.7 (IREF); also elsewhere on the board
unnamed: R16.1, U13.7 (IREF)
unnamed: R18.1, U14.7 (IREF)
unnamed: R20.1, U15.7 (IREF)
unnamed: R22.1, U16.7 (IREF)
unnamed: R24.1, U17.7 (IREF)
unnamed: SW2.1 (RK), U4.1 (OUT0)
unnamed: SW2.2 (GK), U4.2 (OUT1)
unnamed: SW2.4 (BK), U4.3 (OUT2)
unnamed: SW3.1 (RK), U5.1 (OUT0)
unnamed: SW3.2 (GK), U5.2 (OUT1)
unnamed: SW3.4 (BK), U5.3 (OUT2)
unnamed: SW4.1 (RK), U6.1 (OUT0)
unnamed: SW4.2 (GK), U6.2 (OUT1)
unnamed: SW4.4 (BK), U6.3 (OUT2)
unnamed: SW5.1 (RK), U7.1 (OUT0)
unnamed: SW5.2 (GK), U7.2 (OUT1)
unnamed: SW5.4 (BK), U7.3 (OUT2)
unnamed 131: U10.3 (OUT2); also elsewhere on the board
unnamed 132: U10.2 (OUT1); also elsewhere on the board
unnamed 133: U10.1 (OUT0); also elsewhere on the board
unnamed: SW11.1 (RK), U13.1 (OUT0)
unnamed: SW11.2 (GK), U13.2 (OUT1)
unnamed: SW11.4 (BK), U13.3 (OUT2)
unnamed: SW12.1 (RK), U14.1 (OUT0)
unnamed: SW12.2 (GK), U14.2 (OUT1)
unnamed: SW12.4 (BK), U14.3 (OUT2)
unnamed: SW13.1 (RK), U15.1 (OUT0)
unnamed: SW13.2 (GK), U15.2 (OUT1)
unnamed: SW13.4 (BK), U15.3 (OUT2)
unnamed: SW14.1 (RK), U16.1 (OUT0)
unnamed: SW14.2 (GK), U16.2 (OUT1)
unnamed: SW14.4 (BK), U16.3 (OUT2)
unnamed: SW15.1 (RK), U17.1 (OUT0)
unnamed: SW15.2 (GK), U17.2 (OUT1)
unnamed: SW15.4 (BK), U17.3 (OUT2)
VLED: C6.1, C8.1, C10.1, C12.1, C24.1, C26.1, C28.1, C30.1, C32.1, SW2.5 (A), SW3.5 (A), SW4.5 (A), SW5.5 (A), SW11.5 (A), SW12.5 (A), SW13.5 (A), SW14.5 (A), SW15.5 (A); also elsewhere on the board

Notes on the sheet:
5mA Constant Current LED Driver
Drived to Open-Drain Output

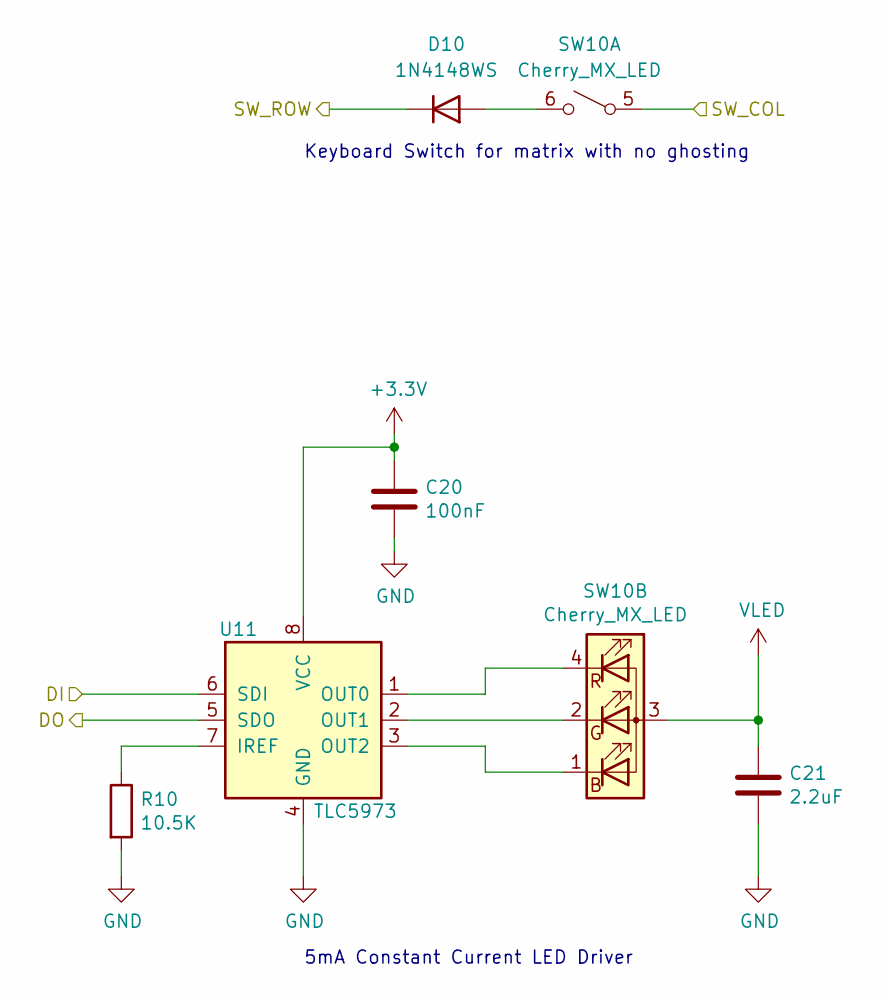
[picture p13: schematic MX_LED_Underneath.sch]

Parts:
C13: 100nF; C_0603_1608Metric_Pad1.08x0.95mm_HandSolder
C14: 2.2uF; C_0805_2012Metric_Pad1.18x1.45mm_HandSolder
D16: 1N4148WS; D_SOD-323_HandSoldering
R11: 10.5K; R_0603_1608Metric_Pad0.98x0.95mm_HandSolder
SW6: Cherry_MX_LED; SW_Cherry_MX_1.00u_PCB_SMD_LED
U8: TLC5973; SOIC-8_3.9x4.9mm_P1.27mm

Connections:
/C1: SW6.5 (SW_A); also elsewhere on the board
/MX_1/DI: U8.6 (SDI); also elsewhere on the board
/PEL12T_1/DI: U8.5 (SDO); also elsewhere on the board
/R2: D16.1 (K); also elsewhere on the board
GND: C13.2, C14.2, R11.2, U8.4 (GND); also elsewhere on the board
unnamed: D16.2 (A), SW6.6 (SW_B)
unnamed: R11.1, U8.7 (IREF)
unnamed: SW6.1 (BK), U8.3 (OUT2)
unnamed: SW6.2 (GK), U8.2 (OUT1)
unnamed: SW6.4 (RK), U8.1 (OUT0)
VLED: C14.1, SW6.3 (A); also elsewhere on the board

Parts of its further copies:
C5, C9, C15, C17, C19, C21, C33, C35, C37, C39, C41: 100nF; C_0603_1608Metric_Pad1.08x0.95mm_HandSolder
C22, C34, C36, C38, C40, C42: 2.2uF; C_0805_2012Metric_Pad1.18x1.45mm_HandSolder
D4, D5, D6, D7, D8, D9, D10, D17, D18, D19, D20, D36, D37, D38, D39, D40: 1N4148WS; D_SOD-323_HandSoldering
R3, R5, R7, R9, R12, R13, R14, R15, R26, R27, R28, R29, R30: 10.5K; R_0603_1608Metric_Pad0.98x0.95mm_HandSolder
SW7, SW8, SW9, SW10, SW16, SW17, SW18, SW19, SW20: Cherry_MX_LED; SW_Cherry_MX_1.00u_PCB_SMD_LED
U4, U5, U6, U7, U9, U10, U11, U12, U18, U19, U20, U21, U22: TLC5973; SOIC-8_3.9x4.9mm_P1.27mm

Connections of its further copies:
/C1: SW16.5 (SW_A); also elsewhere on the board
/C2: D6.2 (A), SW7.5 (SW_A), SW17.5 (SW_A); also elsewhere on the board
/C3: D9.2 (A), SW8.5 (SW_A), SW18.5 (SW_A); also elsewhere on the board
/C4: SW9.5 (SW_A), SW19.5 (SW_A); also elsewhere on the board
/C5: SW10.5 (SW_A), SW20.5 (SW_A); also elsewhere on the board
/DI: U18.6 (SDI); also elsewhere on the board
/DO: U7.5 (SDO); also elsewhere on the board
/MX_2/DI: U4.5 (SDO), U9.6 (SDI)
/MX_3/DI: U10.6 (SDI); also elsewhere on the board
/MX_4/DI: U6.5 (SDO), U11.6 (SDI)
/MX_5/DI: U12.6 (SDI); also elsewhere on the board
/MX_7/DI: U19.6 (SDI); also elsewhere on the board
/MX_8/DI: U19.5 (SDO), U20.6 (SDI)
/MX_9/DI: U21.6 (SDI); also elsewhere on the board
/MX_10/DI: U21.5 (SDO), U22.6 (SDI)
/PEL12T_2/DI: U4.6 (SDI); also elsewhere on the board
/PEL12T_3/DI: U5.6 (SDI), U10.5 (SDO)
/PEL12T_4/DI: U5.5 (SDO), U6.6 (SDI)
/PEL12T_5/DI: U7.6 (SDI), U12.5 (SDO)
/PEL12T_6/DI: U18.5 (SDO); also elsewhere on the board
/PEL12T_7/DI: U9.5 (SDO); also elsewhere on the board
/PEL12T_8/DI: U20.5 (SDO); also elsewhere on the board
/PEL12T_9/DI: U11.5 (SDO); also elsewhere on the board
/PEL12T_10/DI: U22.5 (SDO); also elsewhere on the board
/QA1: D4.1 (K), D7.1 (K), D10.1 (K); also elsewhere on the board
/QB1: D5.1 (K), D8.1 (K); also elsewhere on the board
/R2: D17.1 (K), D18.1 (K), D19.1 (K), D20.1 (K); also elsewhere on the board
/R4: D36.1 (K), D37.1 (K), D38.1 (K), D39.1 (K), D40.1 (K); also elsewhere on the board
GND: C5.2, C9.2, C15.2, C17.2, C19.2, C21.2, C22.2, C33.2, C34.2, C35.2, C36.2, C37.2, C38.2, C39.2, C40.2, C41.2, C42.2, R3.2, R5.2, R7.2, R9.2, R12.2, R13.2, R14.2, R15.2, R26.2, R27.2, R28.2, R29.2, R30.2, U4.4 (GND), U5.4 (GND), U6.4 (GND), U7.4 (GND), U9.4 (GND), U10.4 (GND), U11.4 (GND), U12.4 (GND), U18.4 (GND), U19.4 (GND), U20.4 (GND), U21.4 (GND), U22.4 (GND); also elsewhere on the board
unnamed 43: D4.2 (A); also elsewhere on the board
unnamed 44: D5.2 (A); also elsewhere on the board
unnamed 45: D6.1 (K); also elsewhere on the board
unnamed 46: D7.2 (A); also elsewhere on the board
unnamed 47: D8.2 (A); also elsewhere on the board
unnamed 48: D9.1 (K); also elsewhere on the board
unnamed 49: D10.2 (A); also elsewhere on the board
unnamed: D17.2 (A), SW7.6 (SW_B)
unnamed: D18.2 (A), SW8.6 (SW_B)
unnamed: D19.2 (A), SW9.6 (SW_B)
unnamed: D20.2 (A), SW10.6 (SW_B)
unnamed: D36.2 (A), SW16.6 (SW_B)
unnamed: D37.2 (A), SW17.6 (SW_B)
unnamed: D38.2 (A), SW18.6 (SW_B)
unnamed: D39.2 (A), SW19.6 (SW_B)
unnamed: D40.2 (A), SW20.6 (SW_B)
unnamed: R3.1, U4.7 (IREF)
unnamed: R5.1, U5.7 (IREF)
unnamed: R7.1, U6.7 (IREF)
unnamed: R9.1, U7.7 (IREF)
unnamed: R12.1, U9.7 (IREF)
unnamed: R13.1, U10.7 (IREF)
unnamed: R14.1, U11.7 (IREF)
unnamed: R15.1, U12.7 (IREF)
unnamed: R26.1, U18.7 (IREF)
unnamed: R27.1, U19.7 (IREF)
unnamed: R28.1, U20.7 (IREF)
unnamed: R29.1, U21.7 (IREF)
unnamed: R30.1, U22.7 (IREF)
unnamed 113: U4.1 (OUT0); also elsewhere on the board
unnamed 114: U4.2 (OUT1); also elsewhere on the board
unnamed 115: U4.3 (OUT2); also elsewhere on the board
unnamed 116: U5.1 (OUT0); also elsewhere on the board
unnamed 117: U5.2 (OUT1); also elsewhere on the board
unnamed 118: U5.3 (OUT2); also elsewhere on the board
unnamed 119: U6.1 (OUT0); also elsewhere on the board
unnamed 120: U6.2 (OUT1); also elsewhere on the board
unnamed 121: U6.3 (OUT2); also elsewhere on the board
unnamed 122: U7.1 (OUT0); also elsewhere on the board
unnamed 123: U7.2 (OUT1); also elsewhere on the board
unnamed 124: U7.3 (OUT2); also elsewhere on the board
unnamed: SW7.1 (BK), U9.3 (OUT2)
unnamed: SW7.2 (GK), U9.2 (OUT1)
unnamed: SW7.4 (RK), U9.1 (OUT0)
unnamed: SW8.1 (BK), U10.3 (OUT2)
unnamed: SW8.2 (GK), U10.2 (OUT1)
unnamed: SW8.4 (RK), U10.1 (OUT0)
unnamed: SW9.1 (BK), U11.3 (OUT2)
unnamed: SW9.2 (GK), U11.2 (OUT1)
unnamed: SW9.4 (RK), U11.1 (OUT0)
unnamed: SW10.1 (BK), U12.3 (OUT2)
unnamed: SW10.2 (GK), U12.2 (OUT1)
unnamed: SW10.4 (RK), U12.1 (OUT0)
unnamed: SW16.1 (BK), U18.3 (OUT2)
unnamed: SW16.2 (GK), U18.2 (OUT1)
unnamed: SW16.4 (RK), U18.1 (OUT0)
unnamed: SW17.1 (BK), U19.3 (OUT2)
unnamed: SW17.2 (GK), U19.2 (OUT1)
unnamed: SW17.4 (RK), U19.1 (OUT0)
unnamed: SW18.1 (BK), U20.3 (OUT2)
unnamed: SW18.2 (GK), U20.2 (OUT1)
unnamed: SW18.4 (RK), U20.1 (OUT0)
unnamed: SW19.1 (BK), U21.3 (OUT2)
unnamed: SW19.2 (GK), U21.2 (OUT1)
unnamed: SW19.4 (RK), U21.1 (OUT0)
unnamed: SW20.1 (BK), U22.3 (OUT2)
unnamed: SW20.2 (GK), U22.2 (OUT1)
unnamed: SW20.4 (RK), U22.1 (OUT0)
VLED: C22.1, C34.1, C36.1, C38.1, C40.1, C42.1, SW7.3 (A), SW8.3 (A), SW9.3 (A), SW10.3 (A), SW16.3 (A), SW17.3 (A), SW18.3 (A), SW19.3 (A), SW20.3 (A); also elsewhere on the board

Notes on the sheet:
5mA Constant Current LED Driver
Keyboard Switch for matrix with no ghosting

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
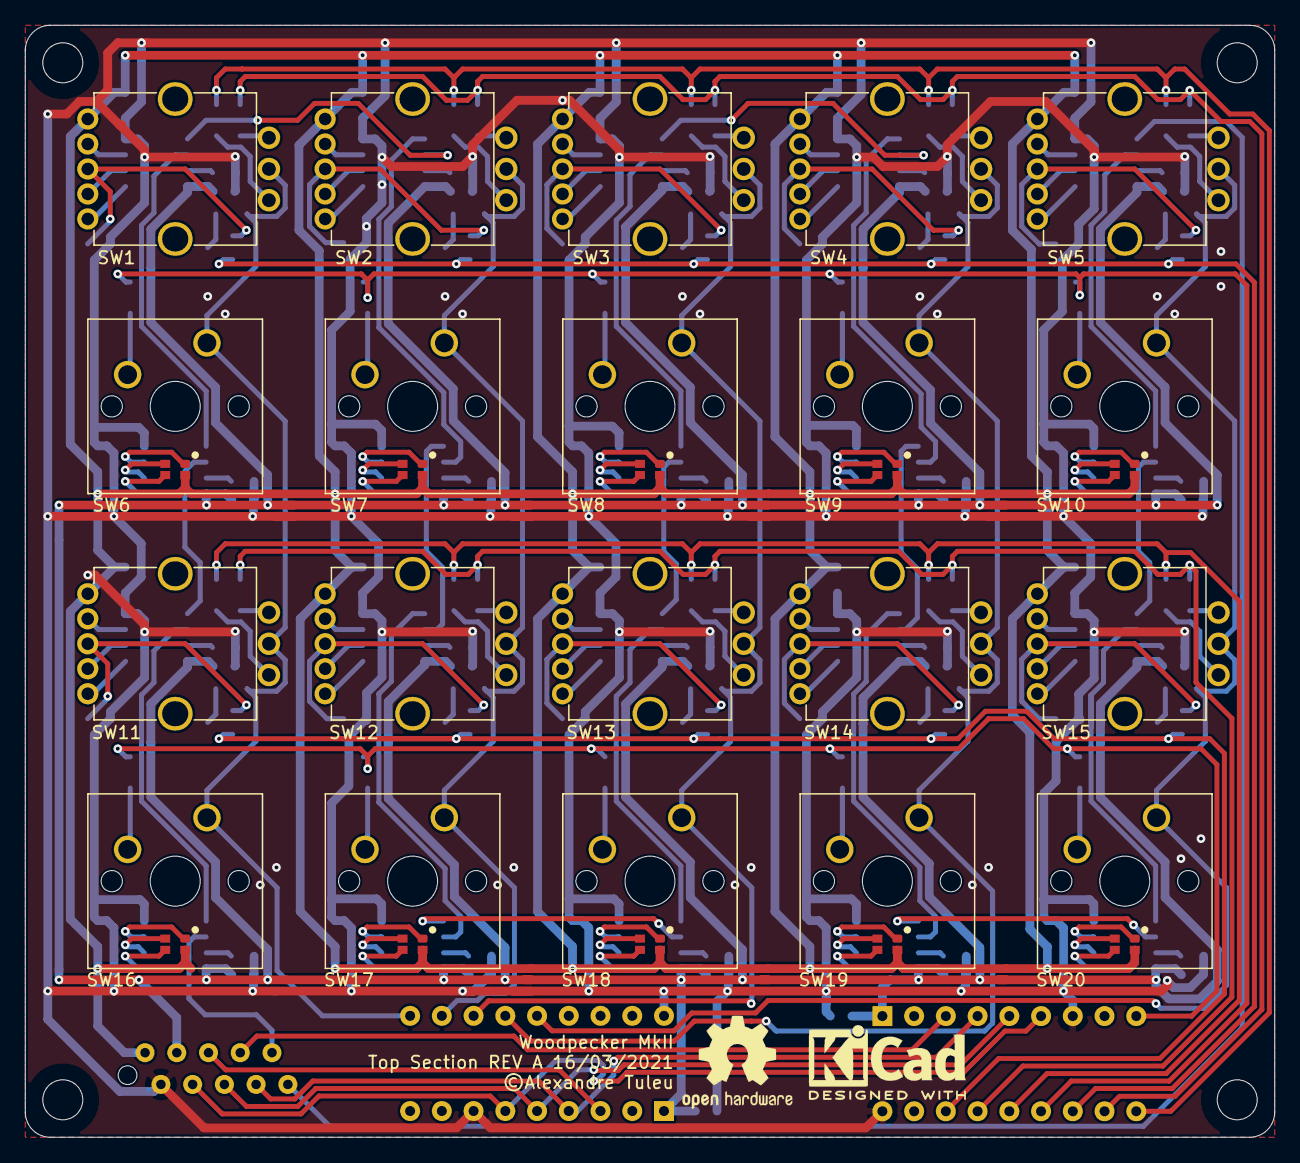
[picture p14: board TopSection.kicad_pcb from above]

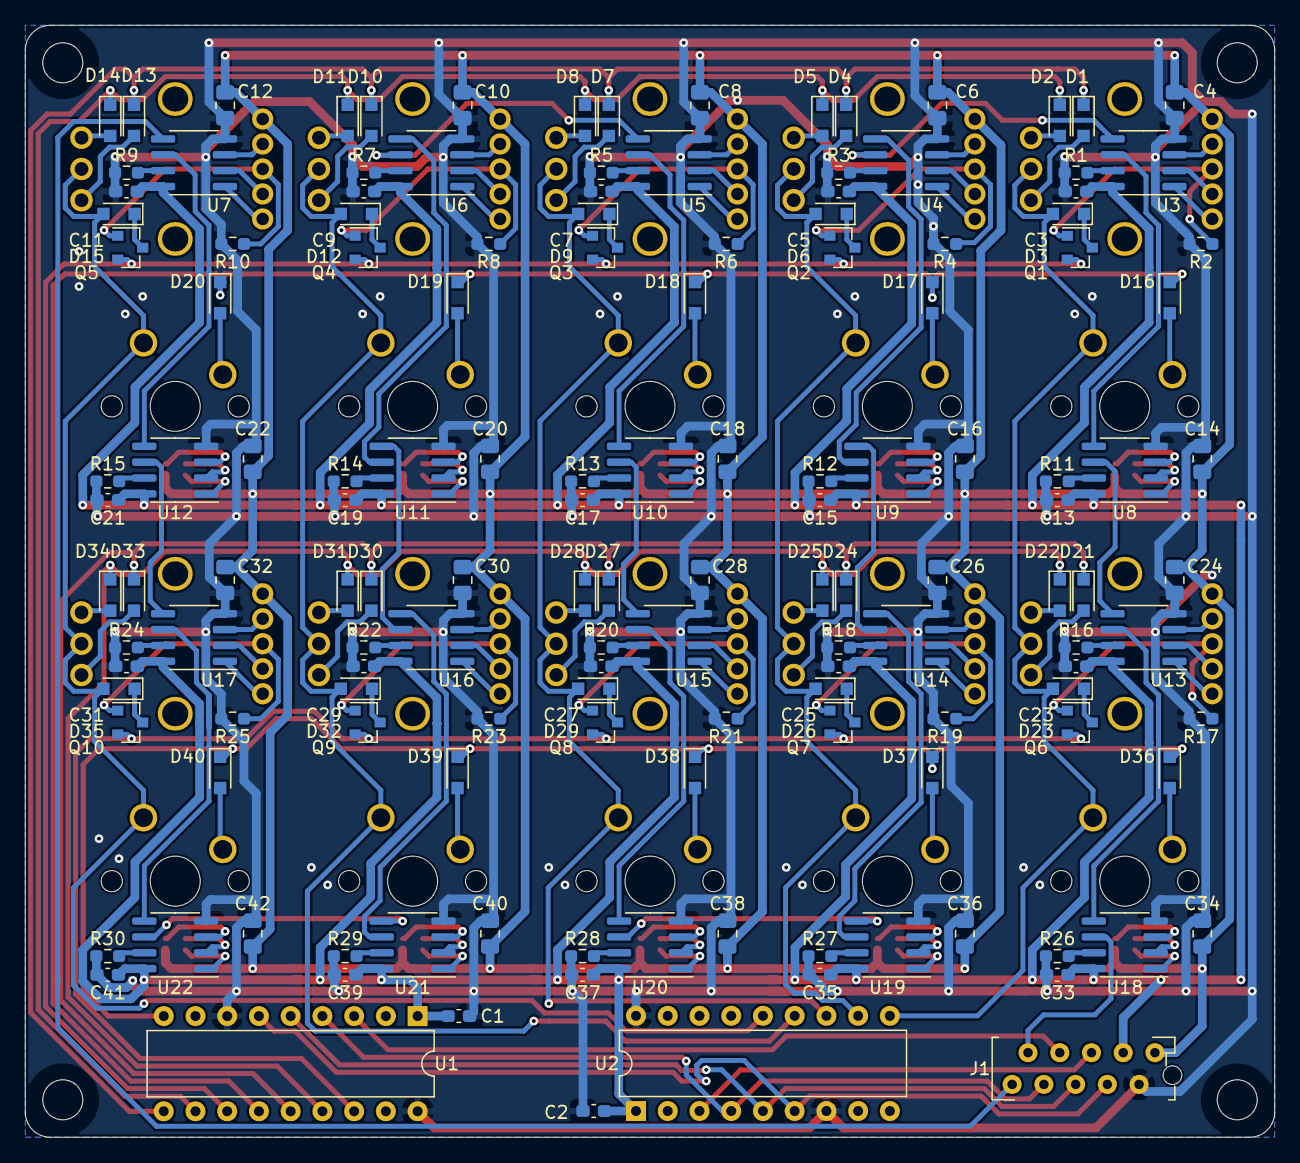
[picture p15: board TopSection.kicad_pcb from below]

Board: 2 copper layers, 100.0 x 89.0 mm, 169 parts (145 on the bottom side), 172 nets.

Other parts of the board:
C16, C18, C20: 2.2uF; C_0805_2012Metric_Pad1.18x1.45mm_HandSolder

Their connections:
GND: C16.2, C18.2, C20.2; also elsewhere on the board
VLED: C16.1, C18.1, C20.1; also elsewhere on the board
