atuleu/woodpecker/ecad/woodpecker/PEL12T_w_Driver.kicad_pcb

## KiCad design ecad/woodpecker/PEL12T_w_Driver.kicad_pcb (2021-03-12)

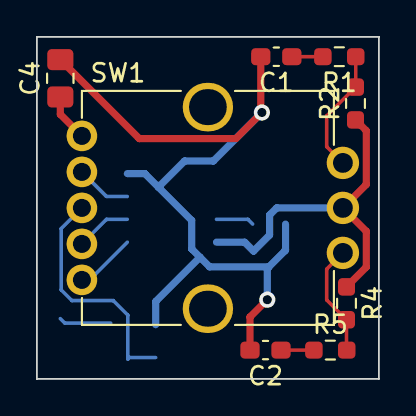
[picture p16: board PEL12T_w_Driver.kicad_pcb from above]

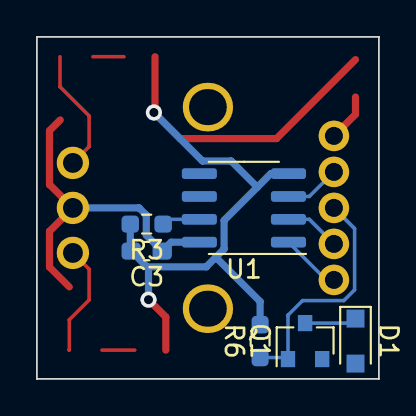
[picture p17: board PEL12T_w_Driver.kicad_pcb from below]

Board: 2 copper layers, 19.0 x 19.0 mm, 14 parts (6 on the bottom side), 13 nets.

Parts:
C1, C2: 10nF; C_0603_1608Metric_Pad1.08x0.95mm_HandSolder
C3: 100nF; C_0603_1608Metric_Pad1.08x0.95mm_HandSolder
C4: 2.2uF; C_0805_2012Metric_Pad1.18x1.45mm_HandSolder
D1: 1N4148WS; D_SOD-323_HandSoldering
Q1: BSS138; SOT-23
R1, R2, R4, R5: 10K; R_0603_1608Metric_Pad0.98x0.95mm_HandSolder
R3, R6: 10.5K; R_0603_1608Metric_Pad0.98x0.95mm_HandSolder
SW1: PEL12T; PEL12T-4xxxS-S1024
U1: TLC5973; SOIC-8_3.9x4.9mm_P1.27mm

Connections:
+3V3: C3.1, R2.1, R4.1, SW1.C, U1.8
/QA: C2.1, R5.1
/QB: C1.1, R1.2
GND: C1.2, C2.2, C3.2, C4.2, R3.2, R6.2, U1.4
unnamed: D1.1, Q1.3
unnamed: Q1.1, R6.1, SW1.3
unnamed: R1.1, R2.2, SW1.B
unnamed: R3.1, U1.7
unnamed: R4.2, R5.2, SW1.A
unnamed: SW1.1, U1.1
unnamed: SW1.2, U1.2
unnamed: SW1.4, U1.3
VLED: C4.1, SW1.5
