atuleu/woodpecker/ecad/woodpecker/woodpecker.kicad_pcb

## KiCad design ecad/woodpecker/woodpecker.kicad_pcb (2021-03-12)

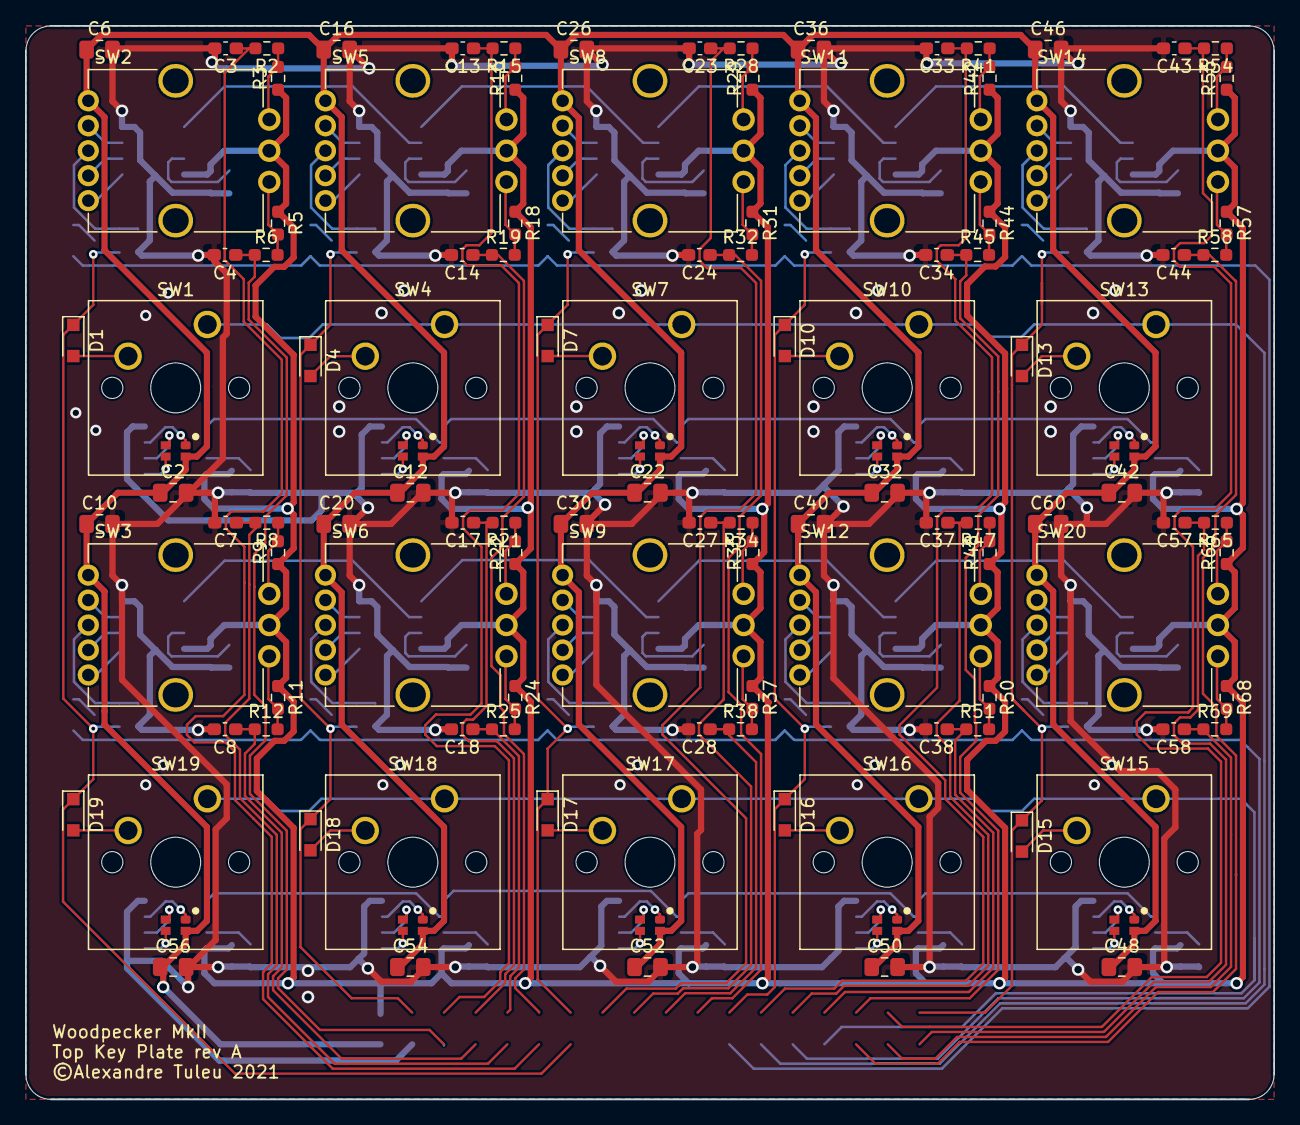
[picture p18: board woodpecker.kicad_pcb from above]

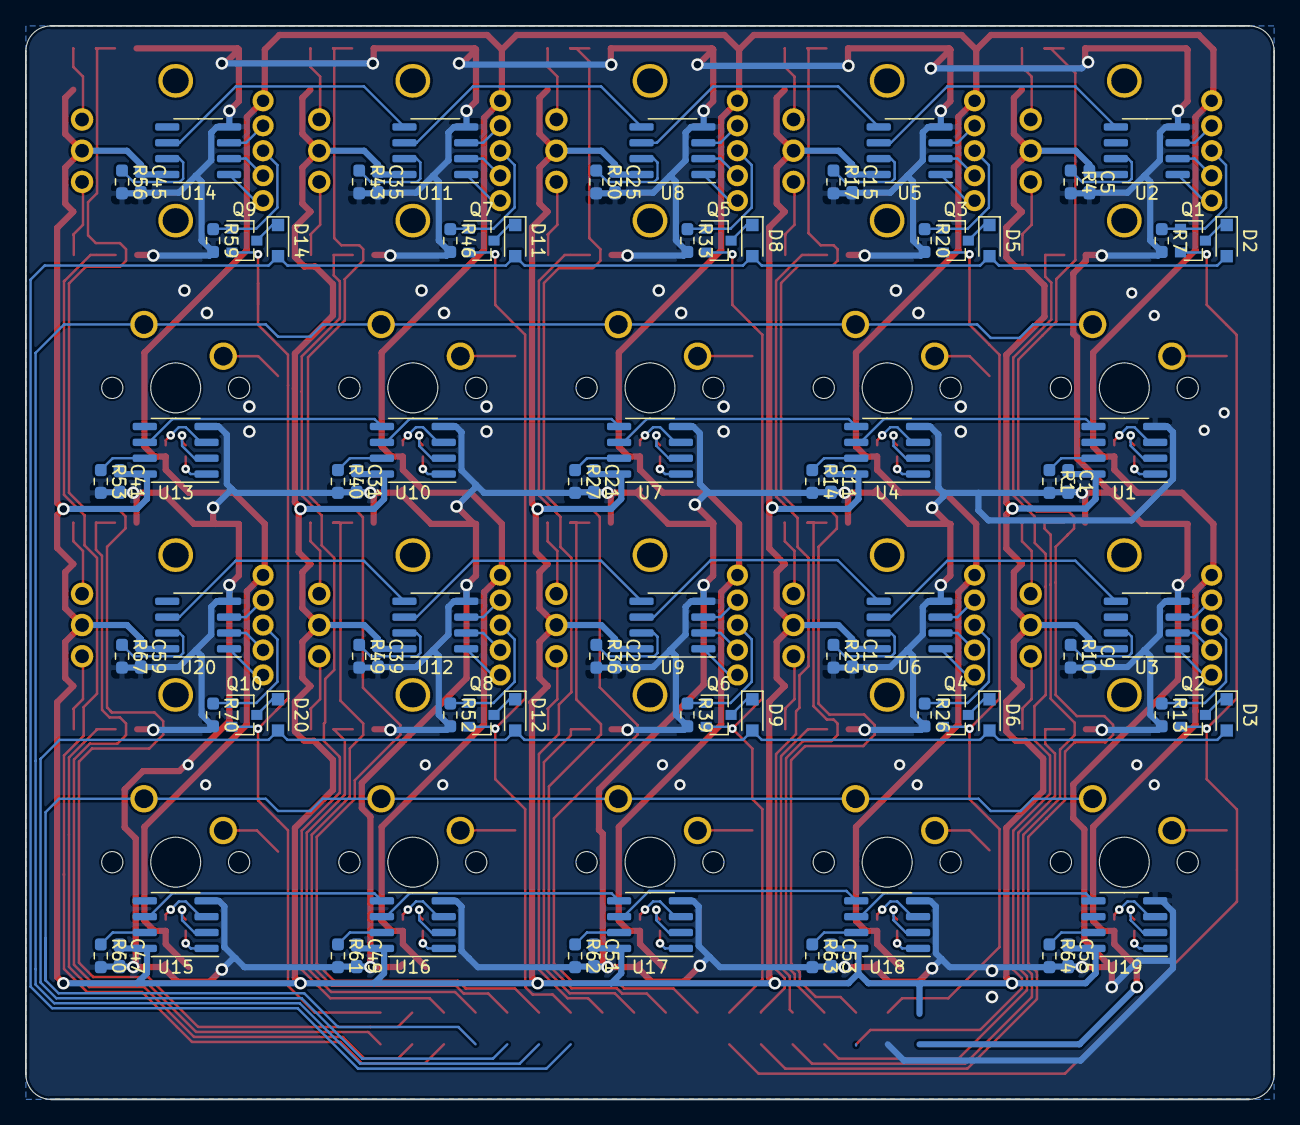
[picture p19: board woodpecker.kicad_pcb from below]

Board: 2 copper layers, 100.0 x 86.0 mm, 200 parts (90 on the bottom side), 178 nets.

Parts:
C1, C5, C9, C11, C15, C19, C21, C25, C29, C31, C35, C39, C41, C45, C47, C49, C51, C53, C55, C59: 100nF; C_0603_1608Metric_Pad1.08x0.95mm_HandSolder
C2, C6, C10, C12, C16, C20, C22, C26, C30, C32, C36, C40, C42, C46, C48, C50, C52, C54, C56, C60: 2.2uF; C_0805_2012Metric_Pad1.18x1.45mm_HandSolder
C3, C4, C7, C8, C13, C14, C17, C18, C23, C24, C27, C28, C33, C34, C37, C38, C43, C44, C57, C58: 10nF; C_0603_1608Metric_Pad1.08x0.95mm_HandSolder
D1, D2, D3, D4, D5, D6, D7, D8, D9, D10, D11, D12, D13, D14, D15, D16, D17, D18, D19, D20: 1N4148WS; D_SOD-323_HandSoldering
Q1, Q2, Q3, Q4, Q5, Q6, Q7, Q8, Q9, Q10: BSS138; SOT-23
R1, R4, R10, R14, R17, R23, R27, R30, R36, R40, R43, R49, R53, R56, R60, R61, R62, R63, R64, R67: 10.5K; R_0603_1608Metric_Pad0.98x0.95mm_HandSolder
R2, R3, R5, R6, R7, R8, R9, R11, R12, R13, R15, R16, R18, R19, R20, R21, R22, R24, R25, R26, R28, R29, R31, R32, R33, R34, R35, R37, R38, R39, R41, R42, R44, R45, R46, R47, R48, R50, R51, R52, R54, R55, R57, R58, R59, R65, R66, R68, R69, R70: 10K; R_0603_1608Metric_Pad0.98x0.95mm_HandSolder
SW1, SW4, SW7, SW10, SW13, SW15, SW16, SW17, SW18, SW19: Cherry_MX_LED; SW_Cherry_MX_1.00u_PCB_SMD_LED
SW2, SW3, SW5, SW6, SW8, SW9, SW11, SW12, SW14, SW20: PEL12T; PEL12T-4xxxS-S1024
U1, U2, U3, U4, U5, U6, U7, U8, U9, U10, U11, U12, U13, U14, U15, U16, U17, U18, U19, U20: TLC5973; SOIC-8_3.9x4.9mm_P1.27mm

Connections:
+3V3: C1.1, C5.1, C9.1, C11.1, C15.1, C19.1, C21.1, C25.1, C29.1, C31.1, C35.1, C39.1, C41.1, C45.1, C47.1, C49.1, C51.1, C53.1, C55.1, C59.1, R3.1, R5.1, R9.1, R11.1, R16.1, R18.1, R22.1, R24.1, R29.1, R31.1, R35.1, R37.1, R42.1, R44.1, R48.1, R50.1, R55.1, R57.1, R66.1, R68.1, SW2.C, SW3.C, SW5.C, SW6.C, SW8.C, SW9.C, SW11.C, SW12.C, SW14.C, SW20.C, U1.8, U2.8, U3.8, U4.8, U5.8, U6.8, U7.8, U8.8, U9.8, U10.8, U11.8, U12.8, U13.8, U14.8, U15.8, U16.8, U17.8, U18.8, U19.8, U20.8
/TopSection_1/COL1: D1.1, D19.1, Q1.2, Q2.2
/TopSection_1/COL2: D4.1, D18.1, Q3.2, Q4.2
/TopSection_1/COL3: D7.1, D17.1, Q5.2, Q6.2
/TopSection_1/COL4: D10.1, D16.1, Q7.2, Q8.2
/TopSection_1/COL5: D13.1, D15.1, Q9.2, Q10.2
/TopSection_1/MX_2/DI: U1.5, U4.6
/TopSection_1/MX_3/DI: U4.5, U7.6
/TopSection_1/MX_4/DI: U7.5, U10.6
/TopSection_1/MX_5/DI: U10.5, U13.6
/TopSection_1/MX_7/DI: U18.6, U19.5
/TopSection_1/MX_8/DI: U17.6, U18.5
/TopSection_1/MX_9/DI: U16.6, U17.5
/TopSection_1/MX_10/DI: U15.6, U16.5
/TopSection_1/PEL12T_2/DI: U2.5, U5.6
/TopSection_1/PEL12T_3/DI: U5.5, U8.6
/TopSection_1/PEL12T_4/DI: U8.5, U11.6
/TopSection_1/PEL12T_5/DI: U11.5, U14.6
/TopSection_1/PEL12T_7/DI: U3.5, U6.6
/TopSection_1/PEL12T_8/DI: U6.5, U9.6
/TopSection_1/PEL12T_9/DI: U9.5, U12.6
/TopSection_1/PEL12T_10/DI: U12.5, U20.6
/TopSection_1/QA1: C4.1, R6.1
/TopSection_1/QA2: C14.1, R19.1
/TopSection_1/QA3: C24.1, R32.1
/TopSection_1/QA4: C34.1, R45.1
/TopSection_1/QA5: C44.1, R58.1
/TopSection_1/QA6: C8.1, R12.1
/TopSection_1/QA7: C18.1, R25.1
/TopSection_1/QA8: C28.1, R38.1
/TopSection_1/QA9: C38.1, R51.1
/TopSection_1/QA10: C58.1, R69.1
/TopSection_1/QB1: C3.1, R2.2
/TopSection_1/QB2: C13.1, R15.2
/TopSection_1/QB3: C23.1, R28.2
/TopSection_1/QB4: C33.1, R41.2
/TopSection_1/QB5: C43.1, R54.2
/TopSection_1/QB6: C7.1, R8.2
/TopSection_1/QB7: C17.1, R21.2
/TopSection_1/QB8: C27.1, R34.2
/TopSection_1/QB9: C37.1, R47.2
/TopSection_1/QB10: C57.1, R65.2
/TopSection_1/R1: D2.2, D5.2, D8.2, D11.2, D14.2
/TopSection_1/R2: SW1.5, SW4.5, SW7.5, SW10.5, SW13.5
/TopSection_1/R3: D3.2, D6.2, D9.2, D12.2, D20.2
/TopSection_1/R4: SW15.5, SW16.5, SW17.5, SW18.5, SW19.5
GND: C1.2, C2.2, C3.2, C4.2, C5.2, C6.2, C7.2, C8.2, C9.2, C10.2, C11.2, C12.2, C13.2, C14.2, C15.2, C16.2, C17.2, C18.2, C19.2, C20.2, C21.2, C22.2, C23.2, C24.2, C25.2, C26.2, C27.2, C28.2, C29.2, C30.2, C31.2, C32.2, C33.2, C34.2, C35.2, C36.2, C37.2, C38.2, C39.2, C40.2, C41.2, C42.2, C43.2, C44.2, C45.2, C46.2, C47.2, C48.2, C49.2, C50.2, C51.2, C52.2, C53.2, C54.2, C55.2, C56.2, C57.2, C58.2, C59.2, C60.2, R1.2, R4.2, R7.2, R10.2, R13.2, R14.2, R17.2, R20.2, R23.2, R26.2, R27.2, R30.2, R33.2, R36.2, R39.2, R40.2, R43.2, R46.2, R49.2, R52.2, R53.2, R56.2, R59.2, R60.2, R61.2, R62.2, R63.2, R64.2, R67.2, R70.2, U1.4, U2.4, U3.4, U4.4, U5.4, U6.4, U7.4, U8.4, U9.4, U10.4, U11.4, U12.4, U13.4, U14.4, U15.4, U16.4, U17.4, U18.4, U19.4, U20.4
unnamed: D1.2, SW1.6
unnamed: D2.1, Q1.3
unnamed: D3.1, Q2.3
unnamed: D4.2, SW4.6
unnamed: D5.1, Q3.3
unnamed: D6.1, Q4.3
unnamed: D7.2, SW7.6
unnamed: D8.1, Q5.3
unnamed: D9.1, Q6.3
unnamed: D10.2, SW10.6
unnamed: D11.1, Q7.3
unnamed: D12.1, Q8.3
unnamed: D13.2, SW13.6
unnamed: D14.1, Q9.3
unnamed: D15.2, SW15.6
unnamed: D16.2, SW16.6
unnamed: D17.2, SW17.6
unnamed: D18.2, SW18.6
unnamed: D19.2, SW19.6
unnamed: D20.1, Q10.3
unnamed: Q1.1, R7.1, SW2.3
unnamed: Q2.1, R13.1, SW3.3
unnamed: Q3.1, R20.1, SW5.3
unnamed: Q4.1, R26.1, SW6.3
unnamed: Q5.1, R33.1, SW8.3
unnamed: Q6.1, R39.1, SW9.3
unnamed: Q7.1, R46.1, SW11.3
unnamed: Q8.1, R52.1, SW12.3
unnamed: Q9.1, R59.1, SW14.3
unnamed: Q10.1, R70.1, SW20.3
unnamed: R1.1, U1.7
unnamed: R2.1, R3.2, SW2.B
unnamed: R4.1, U2.7
unnamed: R5.2, R6.2, SW2.A
unnamed: R8.1, R9.2, SW3.B
unnamed: R10.1, U3.7
unnamed: R11.2, R12.2, SW3.A
unnamed: R14.1, U4.7
unnamed: R15.1, R16.2, SW5.B
unnamed: R17.1, U5.7
unnamed: R18.2, R19.2, SW5.A
unnamed: R21.1, R22.2, SW6.B
unnamed: R23.1, U6.7
unnamed: R24.2, R25.2, SW6.A
unnamed: R27.1, U7.7
unnamed: R28.1, R29.2, SW8.B
unnamed: R30.1, U8.7
unnamed: R31.2, R32.2, SW8.A
unnamed: R34.1, R35.2, SW9.B
unnamed: R36.1, U9.7
unnamed: R37.2, R38.2, SW9.A
unnamed: R40.1, U10.7
unnamed: R41.1, R42.2, SW11.B
unnamed: R43.1, U11.7
unnamed: R44.2, R45.2, SW11.A
unnamed: R47.1, R48.2, SW12.B
unnamed: R49.1, U12.7
unnamed: R50.2, R51.2, SW12.A
unnamed: R53.1, U13.7
unnamed: R54.1, R55.2, SW14.B
unnamed: R56.1, U14.7
unnamed: R57.2, R58.2, SW14.A
unnamed: R60.1, U15.7
unnamed: R61.1, U16.7
unnamed: R62.1, U17.7
unnamed: R63.1, U18.7
unnamed: R64.1, U19.7
unnamed: R65.1, R66.2, SW20.B
unnamed: R67.1, U20.7
unnamed: R68.2, R69.2, SW20.A
unnamed: SW1.1, U1.3
unnamed: SW1.2, U1.2
unnamed: SW1.4, U1.1
unnamed: SW2.1, U2.1
unnamed: SW2.2, U2.2
unnamed: SW2.4, U2.3
unnamed: SW3.1, U3.1
unnamed: SW3.2, U3.2
unnamed: SW3.4, U3.3
unnamed: SW4.1, U4.3
unnamed: SW4.2, U4.2
unnamed: SW4.4, U4.1
unnamed: SW5.1, U5.1
unnamed: SW5.2, U5.2
unnamed: SW5.4, U5.3
unnamed: SW6.1, U6.1
unnamed: SW6.2, U6.2
unnamed: SW6.4, U6.3
unnamed: SW7.1, U7.3
unnamed: SW7.2, U7.2
unnamed: SW7.4, U7.1
unnamed: SW8.1, U8.1
unnamed: SW8.2, U8.2
unnamed: SW8.4, U8.3
unnamed: SW9.1, U9.1
unnamed: SW9.2, U9.2
unnamed: SW9.4, U9.3
unnamed: SW10.1, U10.3
unnamed: SW10.2, U10.2
unnamed: SW10.4, U10.1
unnamed: SW11.1, U11.1
unnamed: SW11.2, U11.2
unnamed: SW11.4, U11.3
unnamed: SW12.1, U12.1
unnamed: SW12.2, U12.2
unnamed: SW12.4, U12.3
unnamed: SW13.1, U13.3
unnamed: SW13.2, U13.2
unnamed: SW13.4, U13.1
unnamed: SW14.1, U14.1
unnamed: SW14.2, U14.2
unnamed: SW14.4, U14.3
unnamed: SW15.1, U15.3
unnamed: SW15.2, U15.2
unnamed: SW15.4, U15.1
unnamed: SW16.1, U16.3
unnamed: SW16.2, U16.2
unnamed: SW16.4, U16.1
unnamed: SW17.1, U17.3
unnamed: SW17.2, U17.2
unnamed: SW17.4, U17.1
unnamed: SW18.1, U18.3
unnamed: SW18.2, U18.2
unnamed: SW18.4, U18.1
unnamed: SW19.1, U19.3
unnamed: SW19.2, U19.2
unnamed: SW19.4, U19.1
unnamed: SW20.1, U20.1
unnamed: SW20.2, U20.2
unnamed: SW20.4, U20.3
VLED: C2.1, C6.1, C10.1, C12.1, C16.1, C20.1, C22.1, C26.1, C30.1, C32.1, C36.1, C40.1, C42.1, C46.1, C48.1, C50.1, C52.1, C54.1, C56.1, C60.1, SW1.3, SW2.5, SW3.5, SW4.3, SW5.5, SW6.5, SW7.3, SW8.5, SW9.5, SW10.3, SW11.5, SW12.5, SW13.3, SW14.5, SW15.3, SW16.3, SW17.3, SW18.3, SW19.3, SW20.5
