atuleu/woodpecker/(commit log)

2021-03-12 layouts a top section
    [MX_1.sch, MX_LED_Underneath.kicad_pcb, MX_LED_Underneath.sch, PEL12T_w_Driver.kicad_pcb, PEL12T_w_Driver.sch, TopSection.sch, woodpecker.kicad_pcb, woodpecker.sch]
2021-03-13 Adds bottom section in monolithic design
    [BottomSection.sch, MX_LED_Underneath.sch, PEL12T_w_Driver.sch, TopSection.sch, woodpecker.sch]
2021-03-13 Corrects Quadrature encoder debounce circuit on put them on the scan matrix
    [MX_LED_Underneath.sch, PEL12T_w_Driver.sch, TopSection.sch]
2021-03-16 Implemented Top Section Revision A
    [MX_LED_Underneath.sch, PEL12T_w_Driver.sch, TopSection.kicad_pcb, TopSection.sch]
2021-03-16 Uses relative paths for libraries
    [MX_LED_Underneath.sch]
2021-03-16 Layouts the bottom section
    [BottomSection.kicad_pcb, BottomSection.sch]
2021-03-17 Builds a middle section electronics
    [MiddleSection.kicad_pcb, MiddleSection.sch]
2021-03-28 Sets debug board
    [BottomSection.kicad_pcb, BottomSection.sch, MX_LED_Underneath.sch, MiddleSection.kicad_pcb, MiddleSection.sch, PEL12T_w_Driver.sch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]
2021-03-29 Makes LED shine !
    Let the LED shine !
    Let the LED shine In !
2021-04-18 Symchronous poll upload of LED data
2022-06-14 MX key drawing
    [mx_front.dxf, mx_side.dxf, mx_top.dxf]
