atuleu/woodpecker/(notices)

Notices in the files:
ecad/TopSection/TopSection.kicad_pcb:
©Alexandre Tuleu
ecad/woodpecker/woodpecker.kicad_pcb:
©Alexandre Tuleu 2021
